kaostheory78/Projet-Balise/Schémas Electriques/Schémas V3 - Routage/Photos 3D/Face avant.PNG

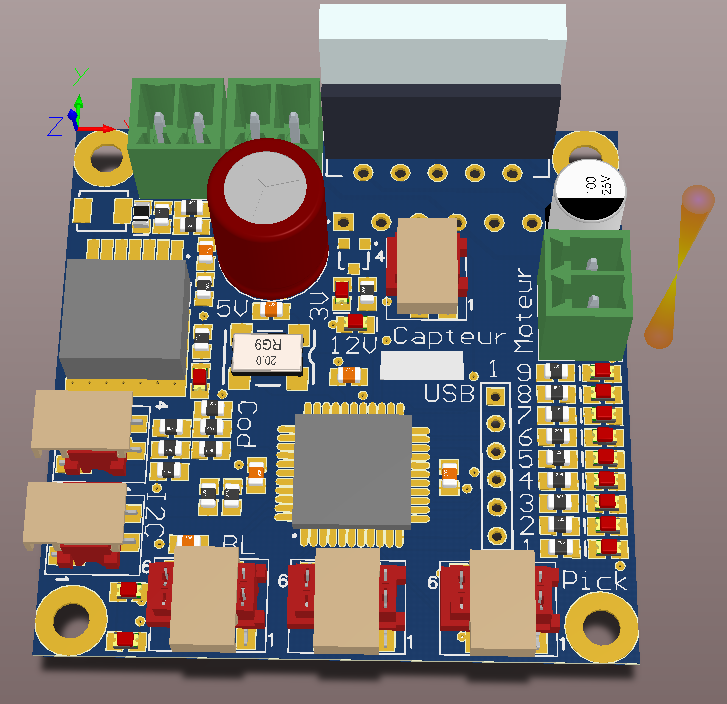
Schémas Electriques/Schémas V3 - Routage/Photos 3D/Face avant.PNG
