kaostheory78/Projet-Balise/Schémas Electriques/Schémas V3 - Routage/Photos 3D/face avant 2.PNG

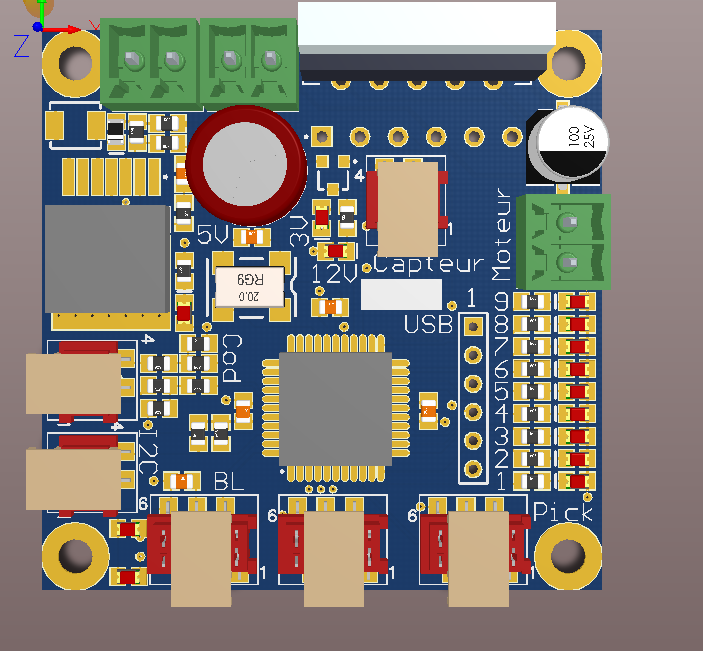
Schémas Electriques/Schémas V3 - Routage/Photos 3D/face avant 2.PNG
