kaostheory78/Projet-Balise/rapports/Cahier des charges - projet balise - V2 (1).docx

Amina chenigle

Julie labeyrie

quentin mercier

Cahier des charges projet M1B

Triangulation de la position d’un robot

Département Energie

PRJ_M1E11

2014/2015

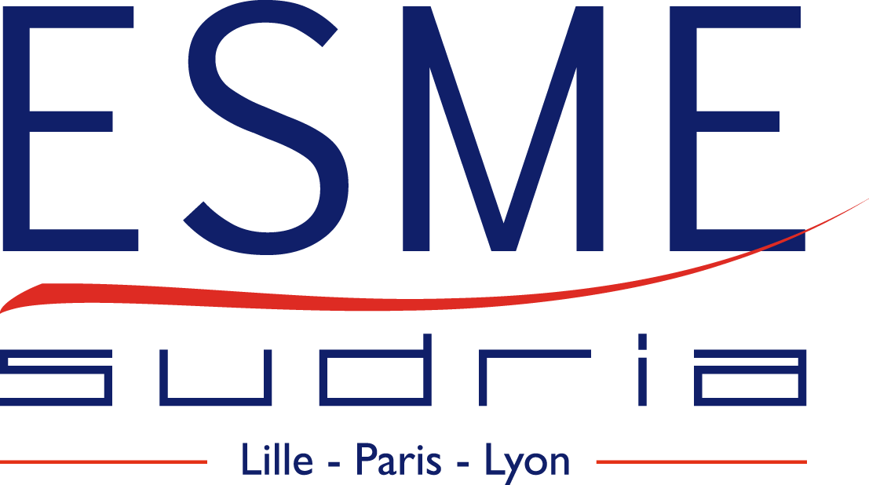
[picture p9: figure]

# Contexte :

L'objectif de notre projet est de réaliser un système de triangulation permettant de localiser un robot, dans notre cas, participant à la coupe de France de robotique (Eurobot).

Le système de triangulation sera composé de 3 balises fixes, et d’une balise sur le robot mobile dont on cherche la position. La position acquise sera transmise par liaison sans-fil par le déterminant (Bluetooth). Une interface sur un ordinateur sera également développée afin d’afficher la position ainsi calculée.

Le système devra respecter les contraintes suivantes :

# I) Contraintes mécaniques :

#### 1. Les balises fixes :

Les balises fixes seront disposées sur des mats sur les bords d’une aire de jeux où évolueront les robots dont on veut connaître la position selon la configuration suivante :

Mats de l’équipe jaune

L’aire de jeux est conçue pour accueillir deux équipes, une équipe verte et une équipe jaune, le schéma ci-dessus nous montre où sont situés les mats en fonction de la couleur de l’équipe.

Les balises fixes ont les contraintes mécaniques suivantes :

- La balise sera située à 350mm par rapport au terrain de jeu
- Hauteur maximale : 160 mm
- Base carré : 80 mm de côté
- Face inférieur recouverte de Velcro (côté velours)

#### 2. Les balises mobiles

Les balises mobiles sont celles qui seront placées sur les robots dont on veut connaître la position, celles-ci devront respecter les spécificités mécaniques suivantes :

- La balise sera placée à une hauteur de 430 mm par rapport au terrain de jeux
- Cube de 80 mm de côté
- Poids inférieur à 400g
- Face inférieur recouverte de Velcro (côté velours)
- Face supérieur recouverte de Velcro (côté crochets)

Le schéma ci-après récapitule le placement des balises.

Robot

Balise mobile

Balise fixe

# II) Contraintes électroniques

Ces balises de triangulation seront, une fois le projet fini, utilisées par l’association Sudriabotik lors de la coupe de robotique (évènement Eurobot), et seront utilisées devant un public non averti , de ce fait les contraintes suivantes devront être respectées :

- Tension maximale : 48V
- Lasers de classe 2, 3 et 4 interdits
- L’intensité lumineuse d’éléments utilisés ne doit pas être nocive pour l’œil humain
- La balise doit disposer d’une batterie pour être alimentée.
- Les balises fixes peuvent être reliées entre elles par un fil

# III) Mise en œuvre

Lors de notre réflexion pour l’élaboration de ce projet nous avons repéré différentes méthodes d’approches pour réaliser cette triangulation. Pour cela nous nous proposons de réaliser un « benchmark » des technologies et d’utiliser celle qui sera la plus adaptée. Ces technologies sont :

- Le laser
- Les émetteurs/récepteurs ultrasons
- Les émetteurs/récepteurs infrarouge
- (Caméra vidéo)

L’émetteur, sera mis en rotation autour de son axe à l’aide d’un moteur entrainant le système à vitesse constante. Dans le cas de l’utilisation d’une source lumineuse, nous utiliserons certainement un miroir.

Nous avons également identifié trois approches complètement différentes :

- La première consisterait à ce que les balises fixes soient des balises réceptrices et que les balises émettrices soient placées sur les robots. Cette technique semble à première vue être la plus simple pour obtenir la distance séparant chaque balise et ainsi pouvoir trianguler la position du robot, mais elle nécessite plus de moyens pour repérer simultanément la position de plusieurs robots.
- La seconde quant à elle serait de placer une balise réceptrice sur le robot et les émettrices sur les mats fixés autour du terrain. Le système pourrait alors repérer la position d’un grand nombre de robot simultanément, cependant la position du robot semble plus compliquée à obtenir
- Enfin la 3ème solution consiste à avoir un émetteur-récepteur sur le robot et une surface réfléchissante sur les balises fixes. C’est certainement la solution la plus simple mais, elle risque de se révéler moins précise.

Emetteur :

(Circuit de charge)

Moteur

Emetteur

Batterie

Puissance

Intelligence électronique

Interface communication filaire

Transmission sans fil

Récepteur :

(Circuit de charge)

Moteur

Conditionneur signal

Récepteur

Batterie

Puissance

Intelligence électronique

Interface communication filaire

Transmission sans fil

Notre démarche s'établira de la façon suivante :

- Mise en place d’un prototype émetteur et un prototype récepteur.
- Réaliser l’algorithme permettant d’obtenir la distance entre les deux balises.
- A partir des résultats, déterminer le choix le plus pertinent à la réalisation du projet (solution numéro 1, 2 ou 3).
- Réalisation d’un émetteur Bluetooth sur l’une des balises afin de renvoyer la position du robot, une fois celle-ci déterminée
- Optimisation du code jusqu’à l’obtention d’une position précise (5 cm) pour le robot.
- Les balises auront une autonomie d’une heure chacune
- Le temps de détermination max est de 1 seconde
- La taille du terrain sur lequel évolueront les robots est de 2m x 3m

# IV) Améliorations

Une fois le travail effectué, nous nous proposons d’améliorer le système de la façon suivante :

- Développement d’une interface recueillant les données envoyées par Bluetooth et affichant la position en temps réel sur une « carte » du terrain à l’ordinateur.
- « Optimisation » du code en étudiant les cas compliqués qui risqueraient d’entrainer des problèmes de mesures (ex : perturbations entrainées par une balise adversaire fonctionnant sur la même technologie que nous).
- Développement, à partir du prototype, et des schémas électriques, du routage de PCB sous Altium Designer en taille CMS.

Nous nous attacherons également à réaliser une base mécanique en PVC propre et répondant au cahier des charges énoncé précédemment.

Annexe :

Le schéma ci-après nous renseigne sur la disposition exacte des mâts (les distances sont en mm).

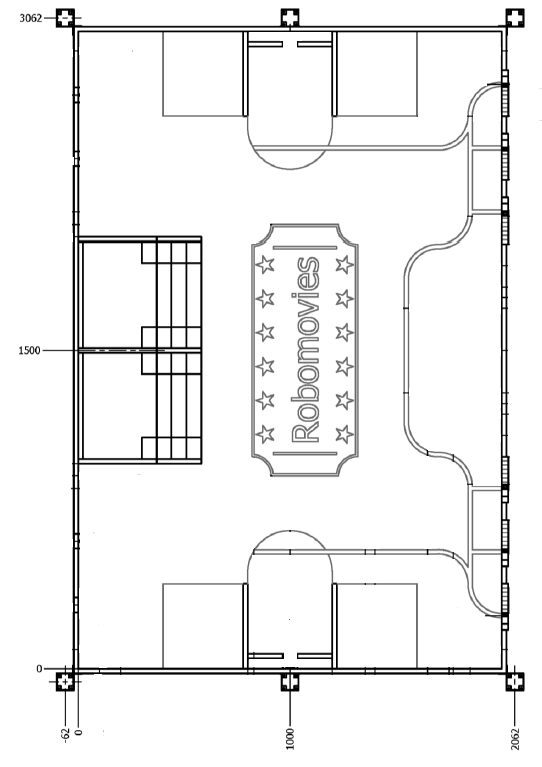
[picture p10: figure]

Position des balises fixes sur le terrain

Chenigle, Labeyrie, Mercier Page 1 / 5 PRJ_M1E11
