kaostheory78/Projet-Balise/rapports/Comparatif méthodes.xlsx

Sheet: Feuil1
 | Thème | Distance | Angle | Précision | Robustesse | Nb de coms | nombre de carte | Compléxité | Triangulation | Possibilité d'utiliser des capteurs industriels | Coût | Utilisation pour la Stratégie
IR | Balise IR simple type Freebot (environs 16 leds) 1 équipe | 2/10 | 5/10 | 0/10 | 6/10 | 1 | 4 | 1/10 | NON | NON | 2/10 | 0/10
 |  | Pas étudié pour, permet uniquement de calculer un angle et à la rigueur d'évaluer une distance | Composé de 16 leds, on a donc une précision de 22° | jusqu'à plus d'1m d'imprécision | Risque de pertubations par d'autres IR | Une balise sur notre robot une sur les robots adverses | Une sur chaque robot | Peu de mise en œuvre |  |  | Composants peu chères | Innutilisable pour tracer la position du robot
 | Balise IR XXL type RCVA (environs 32 leds) +5 équipes | 5/10 | 6/10 | 2/10 | 6/10 | 1 | 4 | 2/10 | NON | NON | 4/10 | 1/10
 |  | Pas étudié pour, permet uniquement de calculer un angle et à la rigueur d'évaluer une distance | Composé de 16 leds, on a donc une précision de 11° | Jusqu'à plus de 70 cm d'imprécision dans le pire des cas | Risque de pertubations par d'autres IR | Une balise sur notre robot une sur les robots adverses | Une sur chaque robot | Peu de mise en œuvre mais une bonne partie hardwaez |  |  | Composants peu chères | Innutilisable pour tracer la position du robot
 | Balise IR - Emeteur/Recepteur séparés Aucune équipe connue à ce jour | 5/10 | 7/10 |  | 4/10 | 7 | 7 | 10/10 | OUI | A voir | 7/10 | 5/10
 |  | Estimation du temps de vol en connaissant la vitesse de rotation de l'éméteur, et en mesurant le temps entre deux états-hauts sur les récepteurs | En cas de synchro rapide avec l'éméteur, peut permetre de récupérer un angle assez précis | Assez lent pour avoir des mesures exploitables | Système relativement pertubable et obligeant à fonctionner à vitesse lente ==> Temps de réponse assez lent | 7 Minimum : 3 balises fixes vers 2 éméteurs plus mobiles plus transfert vers le deuxième robot | Une carte par balise et par robot | Beuacoup de hardware, beaucoup de software, nécéssite une bonne snchronisation. Méthode peu ou pas connue, beaucoup de travail de recherche |  |  | Beaucoup de cartes et beaucoup de composants | Peu de précision car système par définition assez lent
 | Balise IR / Réflecteurs (même technique sans triangulation chez Eceborg, CVRA, Microb, …) | 6/10 | 8/10 | 8/10 | 8/10 | 3 | 4 | 6/10 | OUI | OUI | 5/10 | 8/10
 |  | évaluation possible de la distance par mesure du temps à l'état haut | Obtention de l'angle par rotation d'un moteur et des codeurs (moyennage à 0,5°) | Précis à environ 0,5° soit une erreur de moins de 5 cm | Peu ou pas pertubable | Une par éméteur à la cate de calcul et une au second robot (peut être réduit à 2) | Une par robot | Légère compléxité mécanique |  |  |  | Relevé de position précis
Ultrasons | Balises ultrasons 2 équipes : uart et l'ESEO | 8/10 | 0/10 | 8/10 | 4/10 | 7 | 7 | 9/10 ?? | OUI | NON | 6/10 | 8/10
 |  | Relativemment précis mais dépend des conditions ambiantes | Mesure de temps de vol, mesure de l'angle impossible | Environ 4 cm pour les systèmes existants (Eseo 2011) | Très pertubable, fréquence de drivers de moteurs, zoom de caméras, bruit du publique … | Une par balise et par robot | Une par balise et par robot | Très peu d'informations sur des balises "fonctionnelles sur cette techno |  |  | Beaucoup de cartes | Position plutôt précise pour être utile
Laser | Balise laser type Microb Technology | 10/10 | 10/10 | 10/10 | 10/10 | 7 | 7 | 10/10 | OUI | OUI | 10/10 | 10/10
 |  | Mesure de temps de vol télémétrique (ordre du mm) | précis à 0,1° minimum | Position du robot au cm près minimum (par l'angle) | Seulement une équipe avec le même type de technologie donc non pertubable |  |  | Beaucoup de travail de mise en œuvre |  |  | Laser de classe 1 hors de prix | Solution la plus précise possible
 | Balise laser Balayage laser Type EPFL (suisses) | 8/10 | 8/10 | 8/10 | 6/10 | 7 | 7 | 8/10 | OUI | OUI | 10/10 | 7/10
 |  |  |  |  | Système assez lent
 | Balise laser tournant vs IR (Pas d'équipe) | 4/10 | 6/10 |  | 8/10 | 1 | 4 | 2/10 | NON | OUI | 4/10 | 2/10
 |  | Pas de mesure de temsp de vol | Permet de récupérer un angle dans la mesure de précision des récepteurs IR | Précision limitée car pas de triangulation | Peu pertubable | Recepeteur sur notre robot donc 1 com pour transférer au deuxième robot | Une carte par robot | plutôt simple |  |  | prix du laser IR | Pas de triangulation donc peu utile
 | Légendes | Système Intéressant | Hors Budget | Hors sujet
 |  | Critère satisfaisant | Critère acceptable | critère insatisfaisant

Sheet: Feuil2
Méthode | imprécision |  | données |  |  |  | a1 | a2
IR simple | 22 |  | B1x | 1000 | B1Y | 0 | 90 | 45
 |  |  | B2X | 2000 | B2Y | 3000 | 68 | 23
 |  |  | B3x | 0 | B3Y | 3000 | 112 | 67
 |  |  |  |  |  |  | 68 | 67
 |  |  |  |  |  |  | 112 | 23
 | Formules | Rx | Ry |  | Erreur distance
 | pas d'erreur | 2000 | 1000 |  | 0
 | -22 -22 | 3108.656541 | 2255.97877 |  | 1675.291615
 | +22 +22 | 330.0230594 | 866.6620289 |  | 1675.291615
 | -22 +22 | 13371.31038 | 6402.360065 |  | 12589.36829
 | +22 -22 | 2198.486961 | 111.7536106 |  | 910.153131
IR XXL | imrécision |  | données |  |  |  | a1 | a2
 | 11 |  | B1x | 1000 | B1Y | 0 | 90 | 45
 |  |  | B2X | 2000 | B2Y | 3000 | 79 | 34
 |  |  | B3x | 0 | B3Y | 3000 | 101 | 56
 |  |  |  |  |  |  | 79 | 56
 |  |  |  |  |  |  | 101 | 34
 | Formules | Rx | Ry |  | Erreur distance
 | pas d'erreur | 2000 | 1000 |  | 0
 | -11 -11 | 2676.397041 | 1520.238884 |  | 853.3237688
 | +11 +11 | 1177.970668 | 771.0256975 |  | 853.3237688
 | -11 +11 | 2131.775501 | 1414.375181 |  | 434.8236116
 | +11 -11 | 2055.935382 | 600.366645 |  | 403.5289152
Balise IR réflecteurs | imprécisions |  | données |  |  |  | a1 | a2
 | 0.5 |  | B1x | 1000 | B1Y | 0 | 90 | 45
 |  |  | B2X | 2000 | B2Y | 3000 | 89.5 | 44.5
 |  |  | B3x | 0 | B3Y | 3000 | 90.5 | 45.5
 |  |  |  |  |  |  | 89.5 | 45.5
 |  |  |  |  |  |  | 90.5 | 44.5
 | Formules | Rx | Ry |  | Erreur distance
 | pas d'erreur | 2000 | 1000 |  | 0
 | -0,5 -0,5 | 2034.752508 | 1017.757016 |  | 39.02625316
 | +0,5 +0,5 | 1964.942882 | 982.8522032 |  | 39.02625316
 | -0,5 +0,5 | 2000.155034 | 1017.455089 |  | 17.45577703
 | +0,5 -0,5 | 2000.149715 | 982.5449579 |  | 17.45568417
laser par l'angle | imprécisions |  | données |  |  |  | a1 | a2
 | 0.1 |  | B1x | 1000 | B1Y | 0 | 90 | 45
 |  |  | B2X | 2000 | B2Y | 3000 | 89.9 | 44.9
 |  |  | B3x | 0 | B3Y | 3000 | 90.1 | 45.1
 |  |  |  |  |  |  | 89.9 | 45.1
 |  |  |  |  |  |  | 90.1 | 44.9
 | Formules | Rx | Ry |  | Erreur distance
 | pas d'erreur | 2000 | 1000 |  | 0
 | -0,1 -0,1 | 2006.97521 | 1003.502836 |  | 7.805345738
 | +0,1 +0,1 | 1993.012605 | 996.5215333 |  | 7.805345738
 | -0,1 +0,1 | 2000.006114 | 1003.490673 |  | 3.490678073
 | +0,1 -0,1 | 2000.006071 | 996.5093274 |  | 3.490677924
