kaostheory78/Projet-Balise/rapports/Gantt projet.xlsx

Taches | date début | nombres de semaines | date fin
Tableau comparatif | 2015-01-26 | 1 | 7
Choix de la technologie | 2015-02-02 | 1 | 7
Mode utilisation | 2015-02-02 | 1 | 7
Rapport expliquant choix | 2015-02-02 | 1 | 7
Proto elec | 2015-02-09 | 2 | 14
Proto Meca | 2015-02-09 | 2 | 14
Rapport Protos | 2015-02-16 | 1 | 7
Schémas elec finaux | 2015-02-23 | 1 | 7
Code bas niveau | 2015-02-23 | 1 | 7
Algo haut niveau | 2015-03-02 | 2 | 14
Raport codes | 2015-03-09 | 1 | 7
Test et optimisation | 2015-03-16 | 4 | 28
Logiciel haut niveau | 2015-03-23 | 3 | 21
Routage carte | 2015-03-23 | 2 | 14
Rapport | 2015-04-06 | 1 | 7
Carte finale + méca finale | 2015-04-13 | 2 | 14
Rapport finale | 2015-04-20 | 3 | 21
soutenance | 2015-05-10 | 1 | 7
