kaostheory78/Projet-Balise/rapports/Schémas explicatifs/schéma 1.PNG

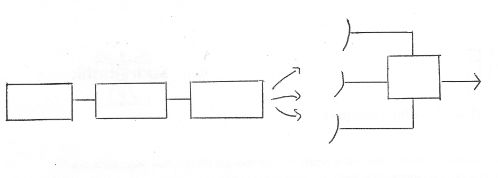
rapports/Schémas explicatifs/schéma 1.PNG
