kaostheory78/Projet-Balise/rapports/Schémas explicatifs/schéma 2.PNG

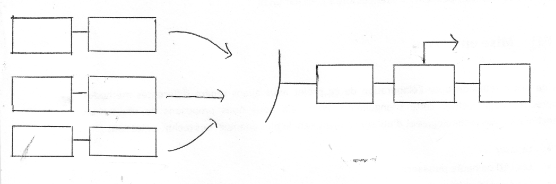
rapports/Schémas explicatifs/schéma 2.PNG
