kaostheory78/Projet-Balise/rapports/Schémas explicatifs/schéma 3.PNG

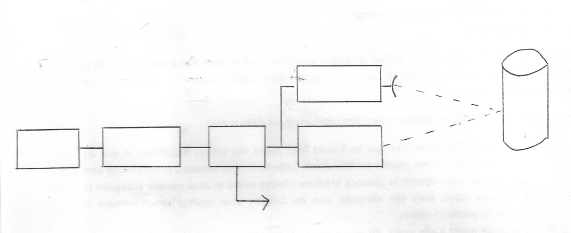
rapports/Schémas explicatifs/schéma 3.PNG
