kaostheory78/Projet-Balise/Schémas Electriques/Schémas V2 - wrapping/Schémas V2 - BOM.xlsx

Report Generated From Altium Designer
Designator | Description | Value | Quantity | Référence
C1, C4 | Capacitor | 27pF | 2
C2, C3 | Capacitor | 10nF | 2
C5 | Capacitor | 220uF | 1
C6, C10, C14 | Capacitor | 1uF | 3
C7 | Capacitor | 100pF | 1
C8 | Capacitor | 100uF | 1
C11, C15 | Capacitor | 10uF | 2
C12 | Capacitor | 330uF | 1
C9, C13, Cap1, Cap2, Cap3, Cap4 | Capacitor | 0.1uF | 6
C16 | Capacitor | 0.2uF | 1
D1, D2, D4, D5, D6 | LED ROUGE |  | 5
D3 | Schottky Diode 1N5820 |  | 1 | 774-3341
J1, J2 | Connecteur 2 voies |  | 2
L1 | Inductor | 15uH | 1 | RS : 540-8538
P1, P4 | Header, 6-Pin |  | 2
P2, P3, P6 | Header, 4-Pin |  | 3
P5 | Header, 2-Pin |  | 1
Q1 | P-Channel Power MOSFET |  | 1 | Farn : 952-4851
Q2 | NPN Bipolar Transistor BC237 |  | 1 | RS : 625-4691
R1, R3, R5, R11, R18, R22 | Resistor | 10K | 6
R2 | Resistor | 100 | 1
R4, R8 | Resistor | 15k | 2
R6, R7, R16, R19, R21 | Resistor | 1K | 5
R9 | Resistor | 330 | 1
R10, R14 | Resistor | 330 | 2
R12 | Resistor | 0R | 1
R13 | Resistor | 3K4 | 1
R15 | Resistor | 470 | 1
R17 | Resistor | 17.4k | 1
R20 | Resistor | 2k | 1
S1 | bouton |  | 1
U1 | PIC 18F4431-I/PT |  | 1
U2 | LMD18200T |  | 1
VR1 | LM2588 |  | 1 | Farn : 9493719
VR2 | LM1117T-5.0 |  | 1 | RS : 535-9256
VR3 | LM1117T-3.0 |  | 1 | RS : 535-9262
Y1 | Crystal Oscillator |  | 1
vendredi 27-févr.-27/2015 3:45:48 PM |  |  |  |  | Page 1 of 1
