kaostheory78/Projet-Balise/Schémas Electriques/Schémas V3 - Routage/Fabrication Outputs/BOM/Bill of Materials-Carte Balise.xls

Description | Designator | Footprint | Quantity | value | Supplier 1 | Supplier Part Number 1 | Supplier 2 | Supplier Part Number 2
Resistor 0805 | R15, R24, R26, R28, R30, R37, R38, R39, R40, R41, R42 | 0805 | 11 | 0R
Resistor 0805 | R2 | 0805 | 1 | 100R
Resistor 0805 | R1, R10, R23, R29, R31 | 0805 | 5 | 10K
Resistor 0805 | R11 | 0805 | 1 | 15k
Resistor 0805 | R19 | 0805 | 1 | 17K4
Resistor 0805 | R3, R4, R12, R13, R14, R18, R20, R25, R27 | 0805 | 9 | 1K
Resistor 0805 | R22 | 0805 | 1 | 215K
Resistor 0805 | R21 | 0805 | 1 | 2k
Resistor 0805 | R5, R6, R16, R43, R44 | 0805 | 5 | 330R
Resistor 0805 | R32 | 0805 | 1 | 3k4
Resistor 0805 | R7, R8, R9, R17, R35, R36, R45, R46, R47 | 0805 | 9 | 470R
connecteur WE, Header, 4-Pin, Header, 4-Pin | J4, P2, P5 | 690367280476 | 3 | 690367280476 | Farnell | 378-4710
Header, 6-Pin | J5, P1, P3 | 690367280676 | 3 | 690367280676 | Farnell | 129-1787
WR-TBL Terminal block - serie 3211 - 3.50 mm | J1, J2, J3 | 691321100002 | 3 | 691321100002 | Farnell | 3704816
Capacitor 0805 | C1, C2, C3, C4, C5, C6, C8, C14, C18 | C0805 | 9 | 100nF
Capacitor 0805 | C7, C22 | C0805 | 2 | 100pF
Capacitor 0805 | C9, C10 | C0805 | 2 | 10nF
Capacitor 0805 | C16, C20 | C0805 | 2 | 10uF
Capacitor 0805 | C12, C15, C19 | C0805 | 3 | 1uF
Capacitor 0805 | C21 | C0805 | 1 | 200nF
Capacitor 1206 | C13 | C1206 | 1 | 100uF | Farnell | 221-1193
EEEFK1C221XP | C11 | Capa CMS D6.3_E1.8 | 1 | 220uF | Farnell | 185-0103
EEUFM1C122L | C17 | CAPA_D10_E5 | 1 | 1200uF | Farnell | 185-5216
Schottky Diode 0805 | D5 | D0805 | 1 | SD0805S040S0R5 | Farnell | 240-0203
Header, 6-Pin | P4 | HDR1X6 | 1 | 690367280676 | Farnell | 129-1787
SRP4020TA-150M | L1 | Inductance 4.06 x 4.45 | 1 | 15uH | farnell | 243-4809
Oscillateur quartz | K1 | IQXO-70 | 1 | 10Mhz | Farnell | 478-8625
Typical RED, GREEN, YELLOW, AMBER GaAs LED 0805 | D1, D2, D8, D13, D14 | LED 0805 | 5 | Bleu
Typical RED, GREEN, YELLOW, AMBER GaAs LED 0805 | D6 | LED 0805 | 1 | Orange
Typical RED, GREEN, YELLOW, AMBER GaAs LED 0805 | D4, D7, D12, D16, D17 | LED 0805 | 5 | Rouge
Typical RED, GREEN, YELLOW, AMBER GaAs LED 0805 | D3, D11, D15 | LED 0805 | 3 | Vert
800mA Low-Dropout Linear Regulator | U5 | MP04A_N | 1 | LM1117IMP-5.0 | Farnell | 240-0655
800mA Low-Dropout Linear Regulator | U3 | MP04A_N | 1 | LM1117MP-3.3 | Farnell | 977-8195
P-Channel Power MOSFET | Q1 | SOT-23 | 1 | NDS0605 | Farnell | 984-6352
NPN Bipolar Transistor | Q2 | SOT23_L | 1 | MMBT2222ALT1G | RS | 544-9400
3A, 55V H-Bridge | U2 | TA11B | 1 | LMD18200T | Farnell | 948-8030
High-Performance 16-bit Digital Signal Controller, 128 KB Flash, 16 KB RAM, 44-Pin TQFP, Industrial Temperature, Tape and Reel | U1 | TQFP-PT44_N | 1 |  | farnell | 157-6810 | Newark | 39M8148
SIMPLE SWITCHER 5A Flyback Regulator with Shutdown | U4 | TS7B_N | 1 | LM2588S-ADJ | Farnell | 232-3492 |  | 533-3412
