kaostheory78/Projet-Balise/Méca/capteur sick.SLDASM

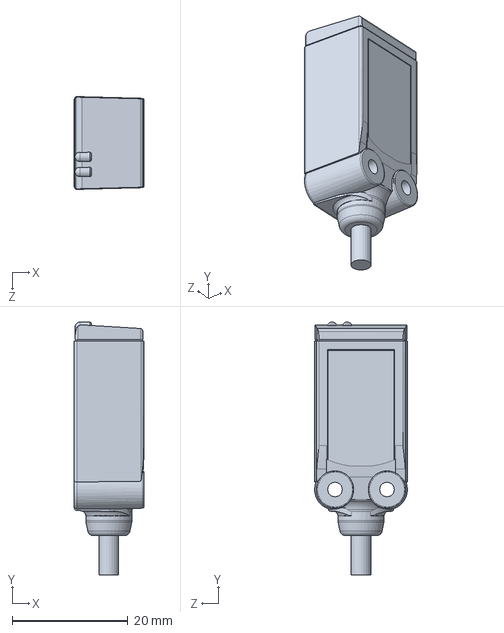
[picture p29: CAD file, 2017-03-19]
Méca/capteur sick.SLDASM
12.1 x 43.8 x 16.1 mm
