kaostheory78/Projet-Balise/Méca/toit.SLDASM

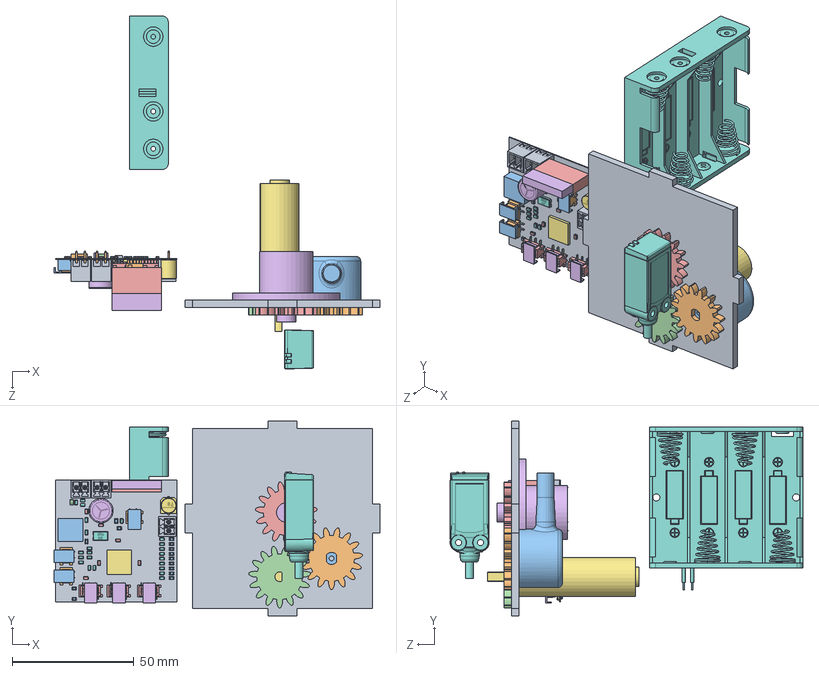
[picture p30: CAD file, 2017-03-19]
Méca/toit.SLDASM
133.7 x 80.0 x 144.9 mm
socle
roue 1 - codeur
codeur
roue 1 - moteur
roue 1 - collecteur
collecteur tournant
moteur
_SICK WL4-3F3130-Order no.1028153_1
Board
Extruded
Extruded_2
Extruded_3
Extruded_4
Extruded_5
Extruded_6
SW3dPS-0805_SMD_Resistor x 45
Extruded_7
Geh__X2__00E4__X0__use x 3
Pick_Pad x 3
Pin x 12
Geh__X2__00E4__X0__use_2 x 3
Pick_Pad_2 x 3
Pin_2 x 18
User_Library-GeyerElectronics_KX12B
6913211000xx_PIN x 6
User_Library-led_0805LED0805_red x 14
User_Library-D0805
SW3dPS-0805_SMD_Capacitor x 19
SW3DPS-ELECTROLITIC_CAPACITOR_RADIAL_10X12-DEFAULT
User_Library-6_3x7_7
User Library-Battery Holder 4xAA
