kaostheory78/Projet-Balise/Schémas Electriques/Schémas V3 - Routage/Fabrication Outputs/ExportSTEP/PCB3 - 5x5 - placement V2.SLDASM

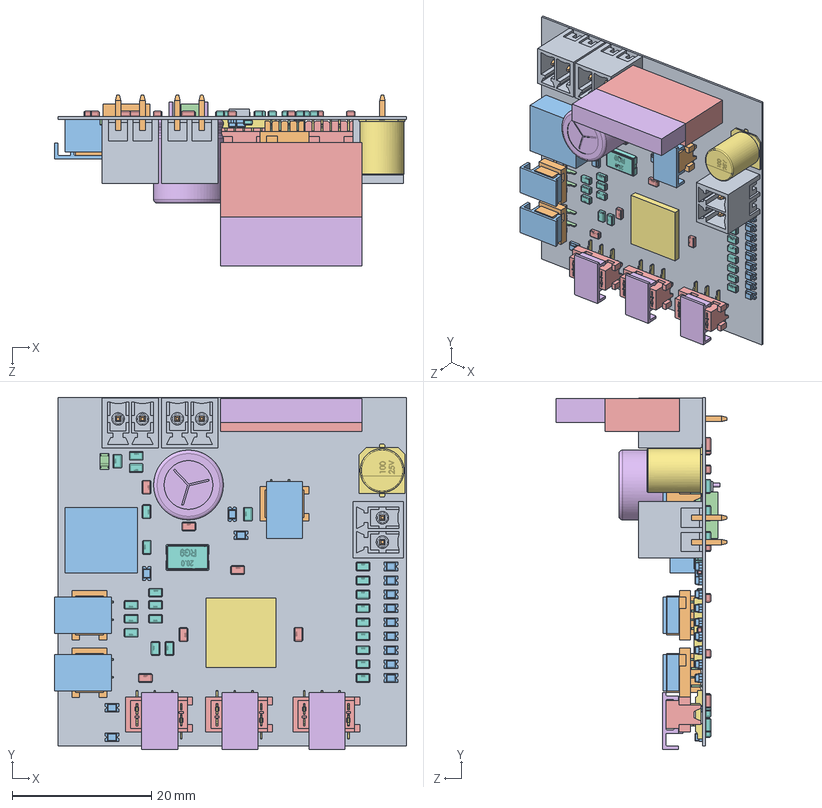
[picture p32: CAD file, 2017-03-19]
Schémas Electriques/Schémas V3 - Routage/Fabrication Outputs/ExportSTEP/PCB3 - 5x5 - placement V2.SLDASM
50.5 x 50.5 x 24.5 mm
Board
Extruded
Extruded_2
Extruded_3
Extruded_4
Extruded_5
Extruded_6
SW3dPS-0805_SMD_Resistor x 45
Extruded_7
Geh__X2__00E4__X0__use x 3
Pick_Pad x 3
Pin x 12
Geh__X2__00E4__X0__use_2 x 3
Pick_Pad_2 x 3
Pin_2 x 18
User_Library-GeyerElectronics_KX12B
6913211000xx_PIN x 6
User_Library-led_0805LED0805_red x 14
User_Library-D0805
SW3dPS-0805_SMD_Capacitor x 19
SW3DPS-ELECTROLITIC_CAPACITOR_RADIAL_10X12-DEFAULT
User_Library-6_3x7_7
