kaostheory78/Projet-Balise/Méca/roue 1 - codeur.SLDPRT

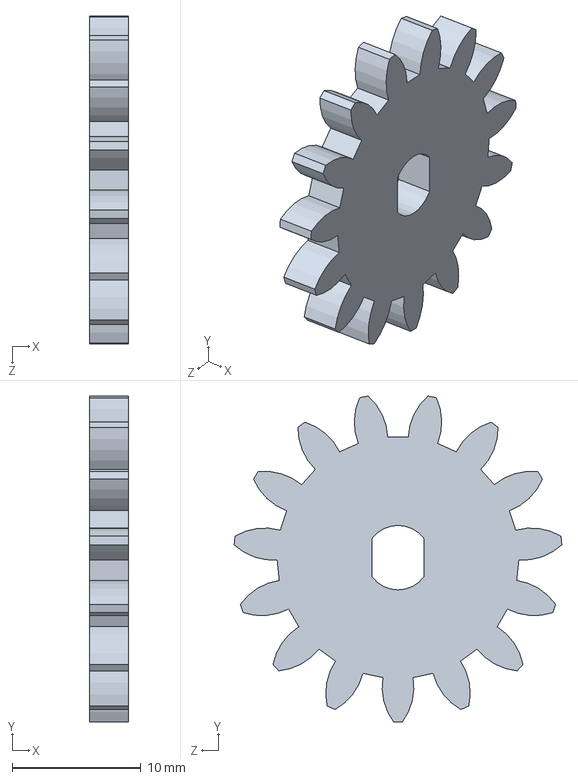
[picture p33: CAD file, 2017-03-19]
Méca/roue 1 - codeur.SLDPRT
3.00 x 25.3 x 25.4 mm
