kaostheory78/Projet-Balise/Méca/codeur.SLDPRT

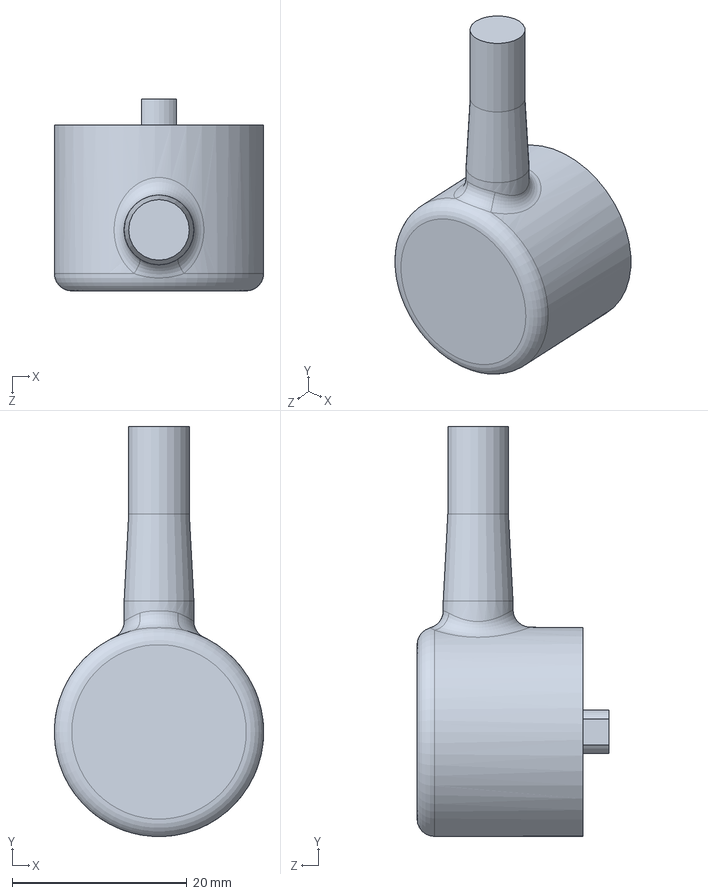
[picture p34: CAD file, 2017-03-19]
Méca/codeur.SLDPRT
24.0 x 47.0 x 22.0 mm
