kaostheory78/Projet-Balise/Méca/moteur.SLDPRT

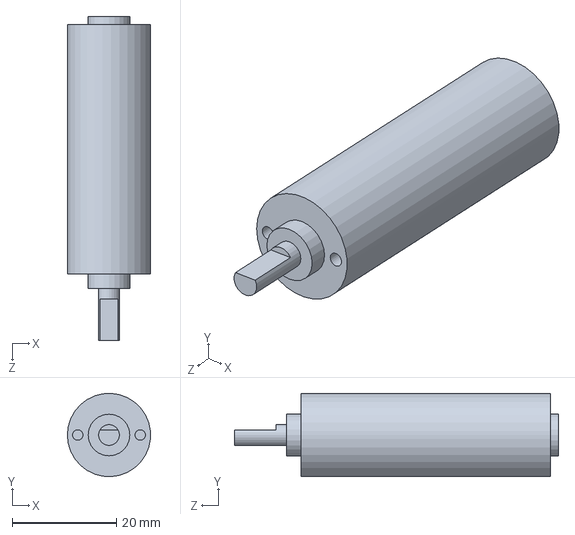
[picture p35: CAD file, 2017-03-19]
Méca/moteur.SLDPRT
16.0 x 16.0 x 62.2 mm
