kaostheory78/Projet-Balise/Méca/socle.SLDPRT

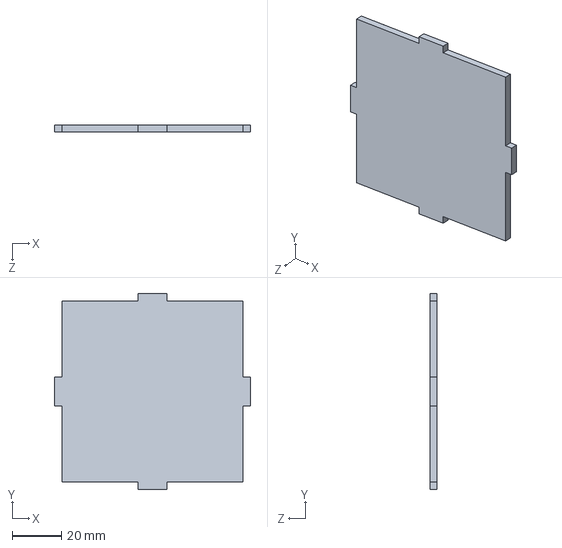
[picture p36: CAD file, 2017-03-19]
Méca/socle.SLDPRT
80.0 x 80.0 x 3.00 mm
