kaostheory78/Projet-Balise/Méca/collecteur tournant.SLDPRT

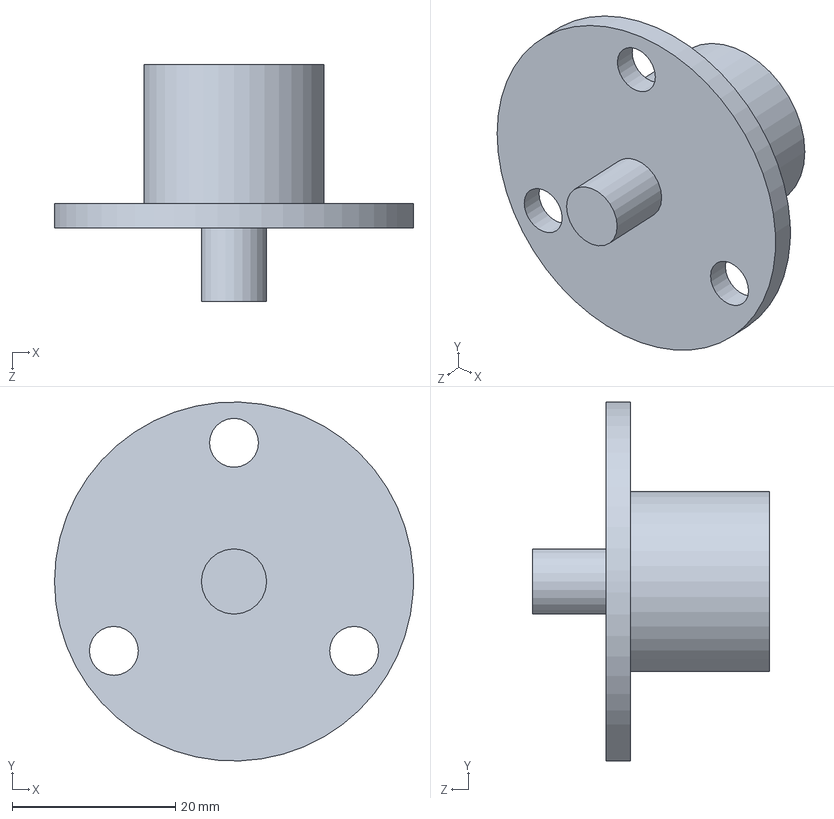
[picture p37: CAD file, 2017-03-19]
Méca/collecteur tournant.SLDPRT
44.0 x 44.0 x 29.0 mm
