kaostheory78/Projet-Balise/Méca/Pile 9V.SLDPRT

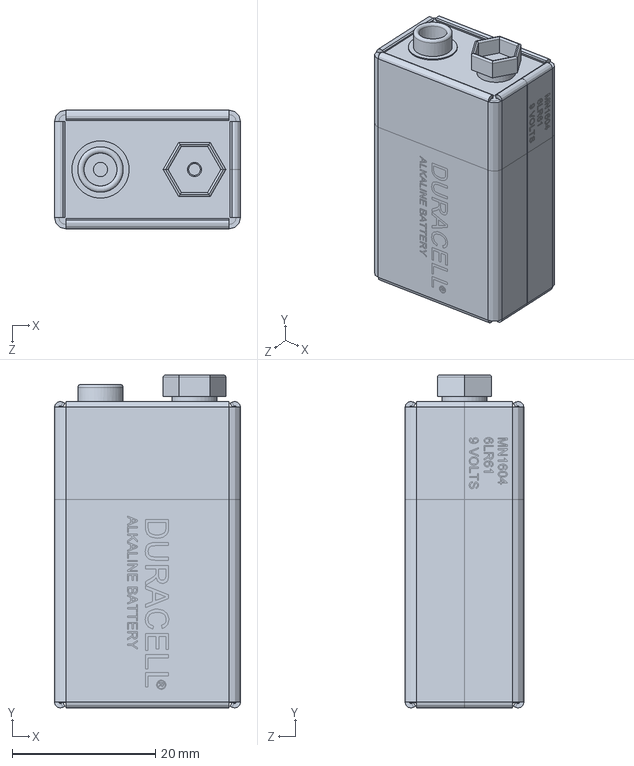
[picture p38: CAD file, 2017-03-19]
Méca/Pile 9V.SLDPRT
26.0 x 46.5 x 16.6 mm
