kaostheory78/Projet-Balise/Méca/User Library-Battery Holder 4xAA.SLDPRT

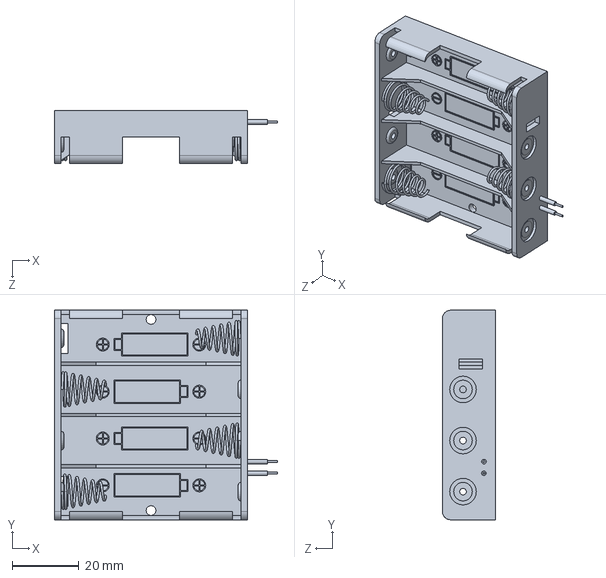
[picture p39: CAD file, 2017-03-19]
Méca/User Library-Battery Holder 4xAA.SLDPRT
67.0 x 63.0 x 16.0 mm
