kaostheory78/Projet-Balise/(list of files, cad)

Other CAD files:
Schémas Electriques/Schémas V3 - Routage/Fabrication Outputs/ExportSTEP/D5.sldasm
Schémas Electriques/Schémas V3 - Routage/Fabrication Outputs/ExportSTEP/U2.sldasm
Schémas Electriques/Schémas V3 - Routage/Fabrication Outputs/ExportSTEP/C20.sldasm
Schémas Electriques/Schémas V3 - Routage/Fabrication Outputs/ExportSTEP/C5.sldasm
Schémas Electriques/Schémas V3 - Routage/Fabrication Outputs/ExportSTEP/C8.sldasm
Schémas Electriques/Schémas V3 - Routage/Fabrication Outputs/ExportSTEP/R11.sldasm
Schémas Electriques/Schémas V3 - Routage/Fabrication Outputs/ExportSTEP/C1.sldasm
Schémas Electriques/Schémas V3 - Routage/Fabrication Outputs/ExportSTEP/D4.sldasm
Schémas Electriques/Schémas V3 - Routage/Fabrication Outputs/ExportSTEP/D9.sldasm
Schémas Electriques/Schémas V3 - Routage/Fabrication Outputs/ExportSTEP/D6.sldasm
Schémas Electriques/Schémas V3 - Routage/Fabrication Outputs/ExportSTEP/R38.sldasm
Schémas Electriques/Schémas V3 - Routage/Fabrication Outputs/ExportSTEP/R35.sldasm
Schémas Electriques/Schémas V3 - Routage/Fabrication Outputs/ExportSTEP/K1.sldasm
Schémas Electriques/Schémas V3 - Routage/Fabrication Outputs/ExportSTEP/R23.sldasm
Schémas Electriques/Schémas V3 - Routage/Fabrication Outputs/ExportSTEP/R6.sldasm
Schémas Electriques/Schémas V3 - Routage/Fabrication Outputs/ExportSTEP/U3.sldasm
Schémas Electriques/Schémas V3 - Routage/Fabrication Outputs/ExportSTEP/P1.sldasm
Schémas Electriques/Schémas V3 - Routage/Fabrication Outputs/ExportSTEP/D15.sldasm
Schémas Electriques/Schémas V3 - Routage/Fabrication Outputs/ExportSTEP/R41.sldasm
Schémas Electriques/Schémas V3 - Routage/Fabrication Outputs/ExportSTEP/J2.sldasm
Schémas Electriques/Schémas V3 - Routage/Fabrication Outputs/ExportSTEP/C16.sldasm
Schémas Electriques/Schémas V3 - Routage/Fabrication Outputs/ExportSTEP/J3.sldasm
Schémas Electriques/Schémas V3 - Routage/Fabrication Outputs/ExportSTEP/R24.sldasm
Schémas Electriques/Schémas V3 - Routage/Fabrication Outputs/ExportSTEP/R5.sldasm
Schémas Electriques/Schémas V3 - Routage/Fabrication Outputs/ExportSTEP/R37.sldasm
Schémas Electriques/Schémas V3 - Routage/Fabrication Outputs/ExportSTEP/P3.sldasm
Schémas Electriques/Schémas V3 - Routage/Fabrication Outputs/ExportSTEP/R42.sldasm
Schémas Electriques/Schémas V3 - Routage/Fabrication Outputs/ExportSTEP/R17.sldasm
Schémas Electriques/Schémas V3 - Routage/Fabrication Outputs/ExportSTEP/R27.sldasm
Schémas Electriques/Schémas V3 - Routage/Fabrication Outputs/ExportSTEP/R13.sldasm
Schémas Electriques/Schémas V3 - Routage/Fabrication Outputs/ExportSTEP/R19.sldasm
Schémas Electriques/Schémas V3 - Routage/Fabrication Outputs/ExportSTEP/R34.sldasm
Schémas Electriques/Schémas V3 - Routage/Fabrication Outputs/ExportSTEP/C22.sldasm
Schémas Electriques/Schémas V3 - Routage/Fabrication Outputs/ExportSTEP/P2.sldasm
Schémas Electriques/Schémas V3 - Routage/Fabrication Outputs/ExportSTEP/C21.sldasm
Schémas Electriques/Schémas V3 - Routage/Fabrication Outputs/ExportSTEP/C13.sldasm
Schémas Electriques/Schémas V3 - Routage/Fabrication Outputs/ExportSTEP/J1.sldasm
Schémas Electriques/Schémas V3 - Routage/Fabrication Outputs/ExportSTEP/C12.sldasm
Schémas Electriques/Schémas V3 - Routage/Fabrication Outputs/ExportSTEP/C9.sldasm
Schémas Electriques/Schémas V3 - Routage/Fabrication Outputs/ExportSTEP/D13.sldasm
Schémas Electriques/Schémas V3 - Routage/Fabrication Outputs/ExportSTEP/D2.sldasm
Schémas Electriques/Schémas V3 - Routage/Fabrication Outputs/ExportSTEP/U4.sldasm
Schémas Electriques/Schémas V3 - Routage/Fabrication Outputs/ExportSTEP/C15.sldasm
Schémas Electriques/Schémas V3 - Routage/Fabrication Outputs/ExportSTEP/P4.sldasm
Schémas Electriques/Schémas V3 - Routage/Fabrication Outputs/ExportSTEP/U1.sldasm
Schémas Electriques/Schémas V3 - Routage/Fabrication Outputs/ExportSTEP/R44.sldasm
Schémas Electriques/Schémas V3 - Routage/Fabrication Outputs/ExportSTEP/C4.sldasm
Schémas Electriques/Schémas V3 - Routage/Fabrication Outputs/ExportSTEP/D11.sldasm
Schémas Electriques/Schémas V3 - Routage/Fabrication Outputs/ExportSTEP/R39.sldasm
Schémas Electriques/Schémas V3 - Routage/Fabrication Outputs/ExportSTEP/C10.sldasm
Schémas Electriques/Schémas V3 - Routage/Fabrication Outputs/ExportSTEP/C2.sldasm
Schémas Electriques/Schémas V3 - Routage/Fabrication Outputs/ExportSTEP/D10.sldasm
Schémas Electriques/Schémas V3 - Routage/Fabrication Outputs/ExportSTEP/R32.sldasm
Schémas Electriques/Schémas V3 - Routage/Fabrication Outputs/ExportSTEP/U5.sldasm
Schémas Electriques/Schémas V3 - Routage/Fabrication Outputs/ExportSTEP/R28.sldasm
Schémas Electriques/Schémas V3 - Routage/Fabrication Outputs/ExportSTEP/C17.sldasm
Schémas Electriques/Schémas V3 - Routage/Fabrication Outputs/ExportSTEP/R1.sldasm
Schémas Electriques/Schémas V3 - Routage/Fabrication Outputs/ExportSTEP/R30.sldasm
Schémas Electriques/Schémas V3 - Routage/Fabrication Outputs/ExportSTEP/R25.sldasm
Schémas Electriques/Schémas V3 - Routage/Fabrication Outputs/ExportSTEP/D12.sldasm
Schémas Electriques/Schémas V3 - Routage/Fabrication Outputs/ExportSTEP/C3.sldasm
Schémas Electriques/Schémas V3 - Routage/Fabrication Outputs/ExportSTEP/D3.sldasm
Schémas Electriques/Schémas V3 - Routage/Fabrication Outputs/ExportSTEP/R26.sldasm
Schémas Electriques/Schémas V3 - Routage/Fabrication Outputs/ExportSTEP/R7.sldasm
Schémas Electriques/Schémas V3 - Routage/Fabrication Outputs/ExportSTEP/R9.sldasm
Schémas Electriques/Schémas V3 - Routage/Fabrication Outputs/ExportSTEP/D8.sldasm
Schémas Electriques/Schémas V3 - Routage/Fabrication Outputs/ExportSTEP/C7.sldasm
Schémas Electriques/Schémas V3 - Routage/Fabrication Outputs/ExportSTEP/R12.sldasm
Schémas Electriques/Schémas V3 - Routage/Fabrication Outputs/ExportSTEP/R10.sldasm
Schémas Electriques/Schémas V3 - Routage/Fabrication Outputs/ExportSTEP/R45.sldasm
Schémas Electriques/Schémas V3 - Routage/Fabrication Outputs/ExportSTEP/C11.sldasm
Schémas Electriques/Schémas V3 - Routage/Fabrication Outputs/ExportSTEP/D7.sldasm
Schémas Electriques/Schémas V3 - Routage/Fabrication Outputs/ExportSTEP/C6.sldasm
Schémas Electriques/Schémas V3 - Routage/Fabrication Outputs/ExportSTEP/C14.sldasm
Schémas Electriques/Schémas V3 - Routage/Fabrication Outputs/ExportSTEP/J5.sldasm
Schémas Electriques/Schémas V3 - Routage/Fabrication Outputs/ExportSTEP/R22.sldasm
Schémas Electriques/Schémas V3 - Routage/Fabrication Outputs/ExportSTEP/R18.sldasm
Schémas Electriques/Schémas V3 - Routage/Fabrication Outputs/ExportSTEP/R33.sldasm
Schémas Electriques/Schémas V3 - Routage/Fabrication Outputs/ExportSTEP/R4.sldasm
Schémas Electriques/Schémas V3 - Routage/Fabrication Outputs/ExportSTEP/R16.sldasm
Schémas Electriques/Schémas V3 - Routage/Fabrication Outputs/ExportSTEP/R43.sldasm
Schémas Electriques/Schémas V3 - Routage/Fabrication Outputs/ExportSTEP/R21.sldasm
Schémas Electriques/Schémas V3 - Routage/Fabrication Outputs/ExportSTEP/J4.sldasm
Schémas Electriques/Schémas V3 - Routage/Fabrication Outputs/ExportSTEP/R36.sldasm
Schémas Electriques/Schémas V3 - Routage/Fabrication Outputs/ExportSTEP/R15.sldasm
Schémas Electriques/Schémas V3 - Routage/Fabrication Outputs/ExportSTEP/R29.sldasm
Schémas Electriques/Schémas V3 - Routage/Fabrication Outputs/ExportSTEP/R14.sldasm
Schémas Electriques/Schémas V3 - Routage/Fabrication Outputs/ExportSTEP/R31.sldasm
Schémas Electriques/Schémas V3 - Routage/Fabrication Outputs/ExportSTEP/D1.sldasm
Schémas Electriques/Schémas V3 - Routage/Fabrication Outputs/ExportSTEP/R20.sldasm
Schémas Electriques/Schémas V3 - Routage/Fabrication Outputs/ExportSTEP/R8.sldasm
Schémas Electriques/Schémas V3 - Routage/Fabrication Outputs/ExportSTEP/D14.sldasm
Schémas Electriques/Schémas V3 - Routage/Fabrication Outputs/ExportSTEP/C18.sldasm
Schémas Electriques/Schémas V3 - Routage/Fabrication Outputs/ExportSTEP/Q2.sldasm
Schémas Electriques/Schémas V3 - Routage/Fabrication Outputs/ExportSTEP/R3.sldasm
Schémas Electriques/Schémas V3 - Routage/Fabrication Outputs/ExportSTEP/R2.sldasm
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
