kaostheory78/Projet-Balise/rapports/Projet balise - Gantt.pdf

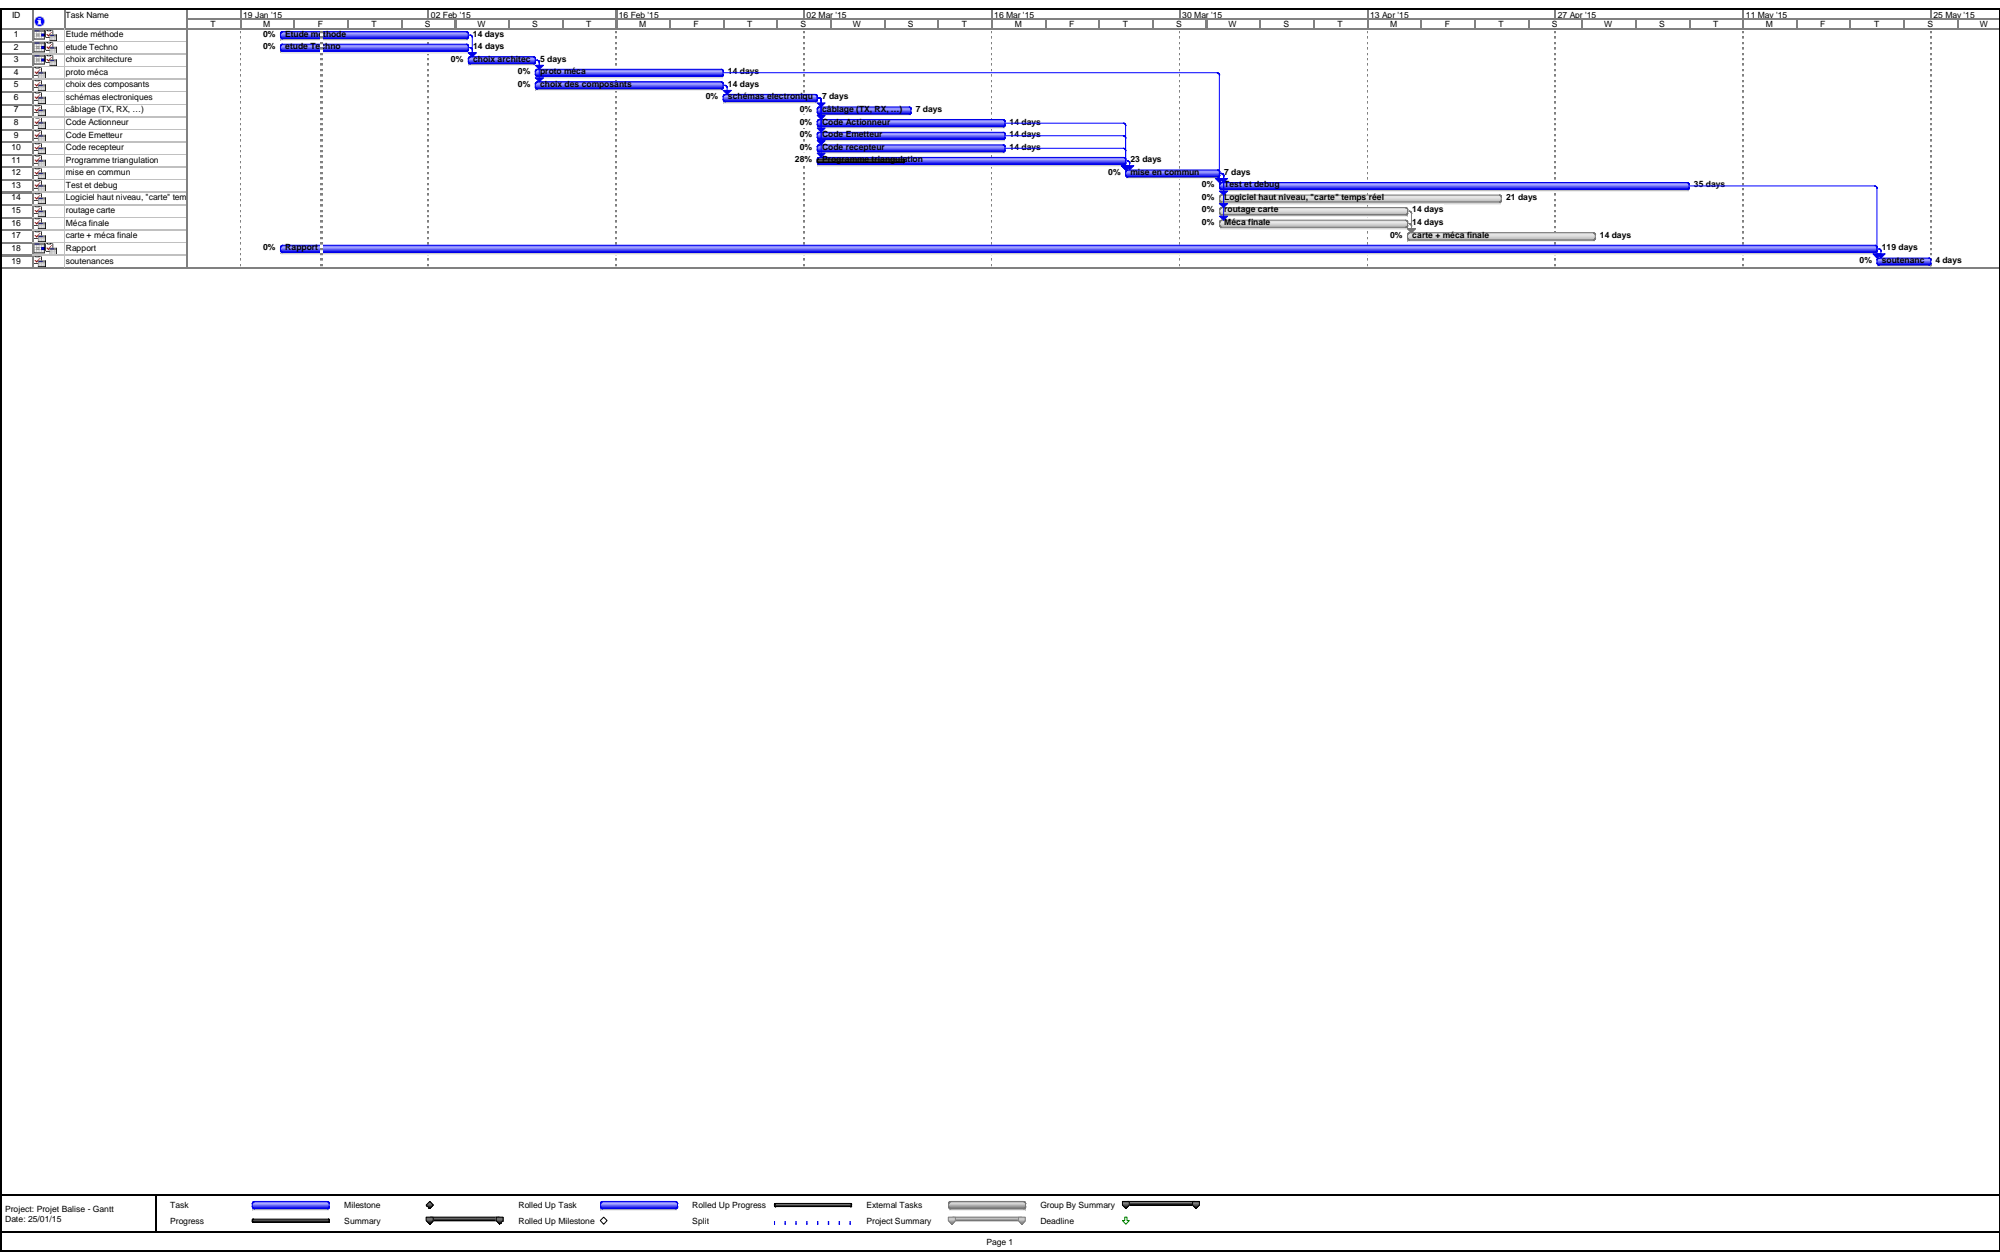
[picture p42: page 1]
0% etude Techno; 14 days; proto méca; câblage (TX, RX, …); 7 days; Code Actionneur; Code Emetteur; Code recepteur; 28% Programme triangulation; 23 days; 0% mise en commun; Test et debug; 35 days; Logiciel haut niveau, "carte" temps réel; 21 days; routage carte; 0% Méca finale; 0% Rapport; 119 days; Task; Progress; Milestone; Summary; External Tasks; Project Summary

ID | | Task Name | | 19 Jan '15 | 02 Feb '15 | 16 Feb '15 | 02 Mar '15 | 16 Mar '15 | 30 Mar '15 | 13 Apr '15 | 27 Apr '15 | 11 May '15 | 25 May '15

1 | | Etude méthode | | 0% Etude méthode | | 14 days | | | | | | | | 4 days
2 | | | etude Techno
3 | | | choix architecture | | | | 0% choix architec 5 days
4 5 | proto méca choix des composants | 0% choix des composants | 14 days

6 | schémas electroniques | 0% schémas electroniqu 7 days
7 | câblage (TX, RX, …)
8 | Code Actionneur
9 | Code Emetteur
10 | Code recepteur
11 | Programme triangulation
12 | mise en commun
13 | Test et debug
14 | Logiciel haut niveau, "carte" temps réel | | | 14 days
15 | routage carte | | 0% carte + méca finale
16 | Méca finale
17 | carte + méca finale
18 | Rapport
19 | soutenances | | | 0% soutenanc

Project: Projet Balise - Gantt
Date: 25/01/15

Rolled Up Task
Rolled Up Milestone

Rolled Up Progress
Split

Group By Summary
Deadline

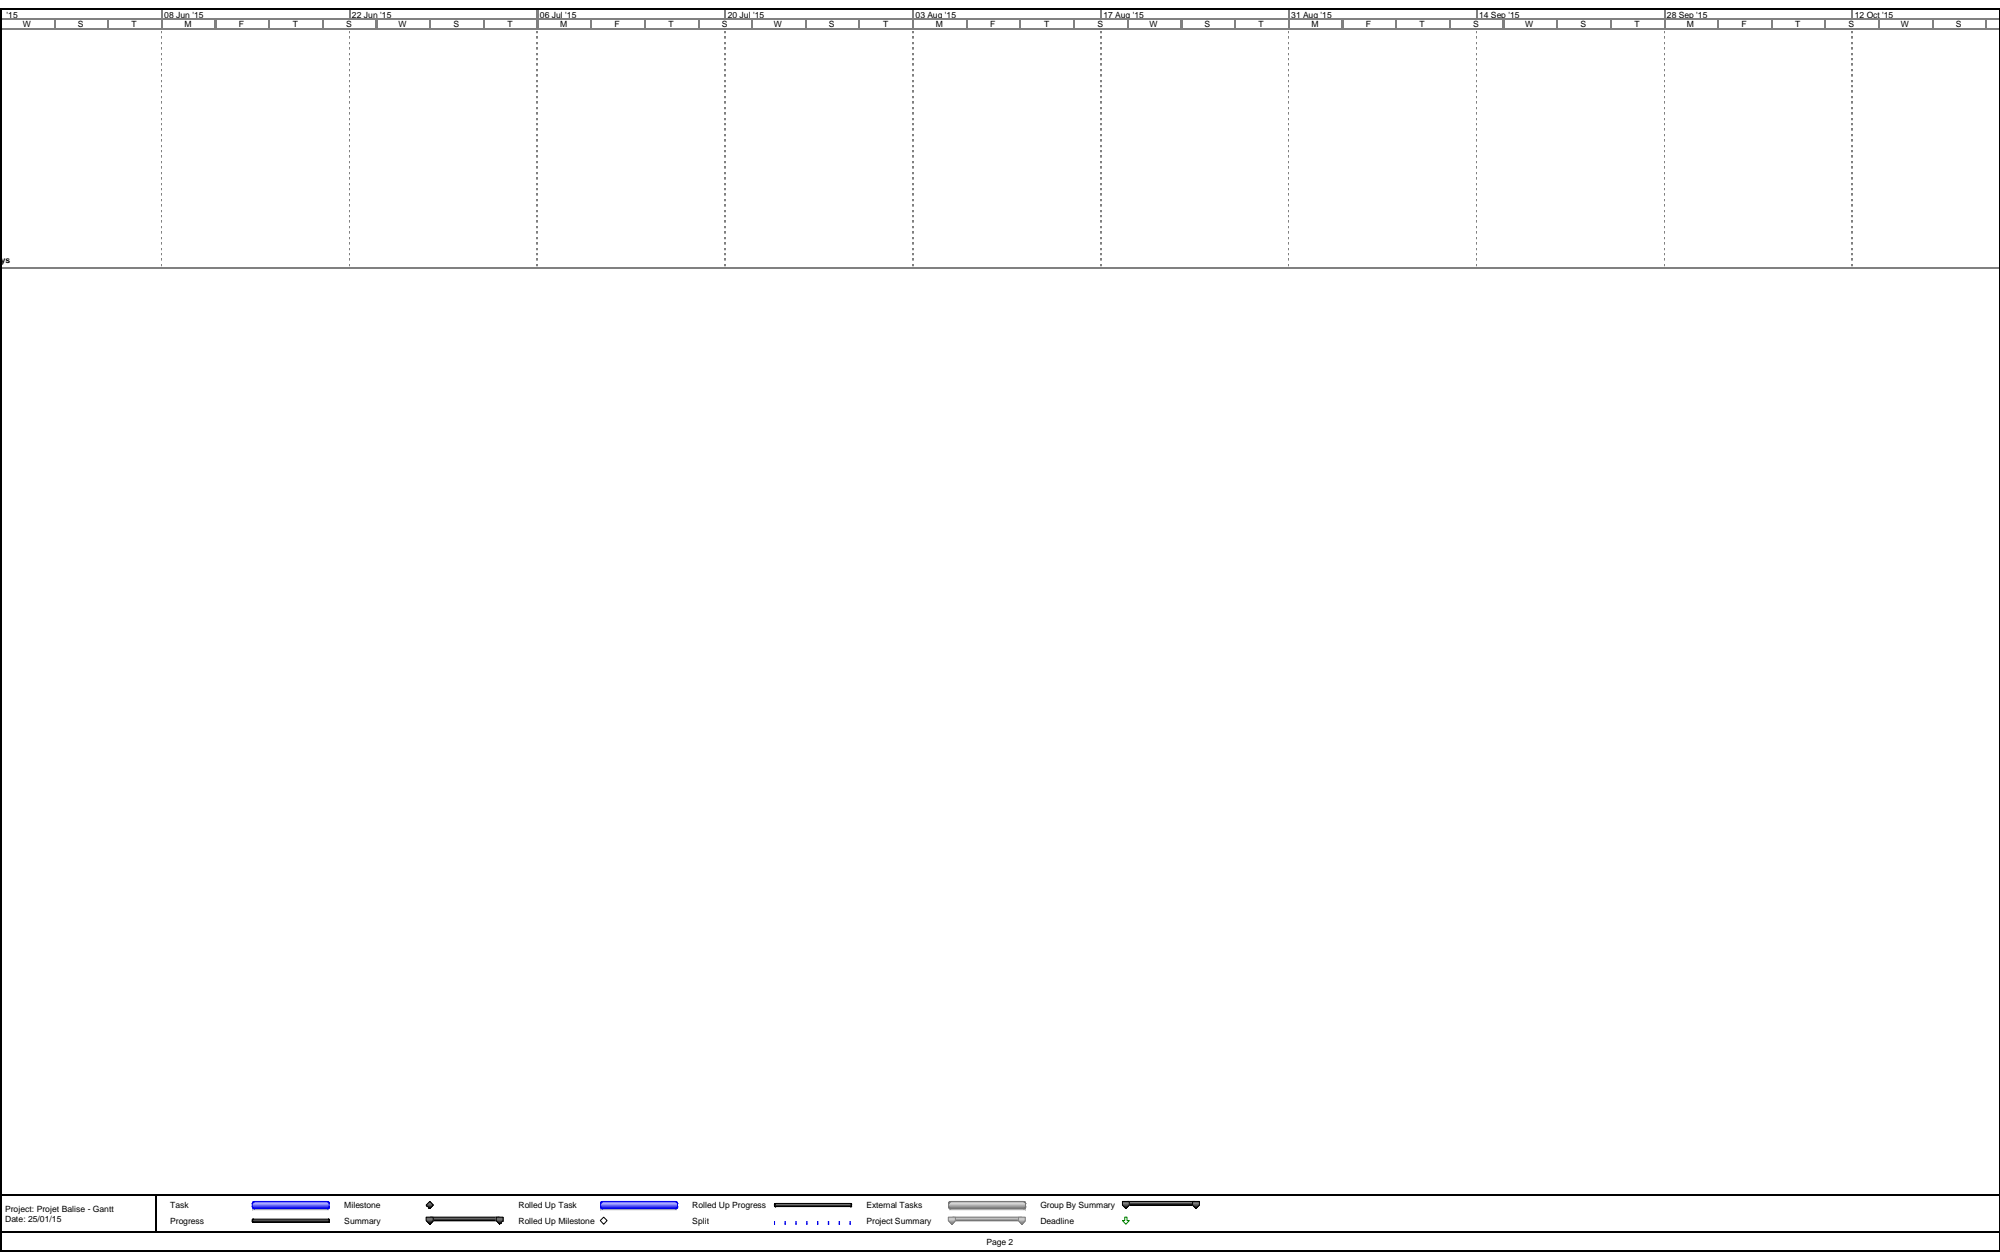
[picture p43: page 2]
Task; Progress; Milestone; Summary; External Tasks; Project Summary

'15 | 08 Jun '15 | 22 Jun '15 | 06 Jul '15 | 20 Jul '15 | 03 Aug '15 | 17 Aug '15 | 31 Aug '15 | 14 Sep '15 | 28 Sep '15 | 12 Oct '15

Project: Projet Balise - Gantt
Date: 25/01/15

Rolled Up Task
Rolled Up Milestone

Rolled Up Progress
Split

Group By Summary
Deadline
