kaostheory78/Projet-Balise/Schémas Electriques/Schémas V3 - Routage/Fabrication Outputs/Carte Balise.PDF

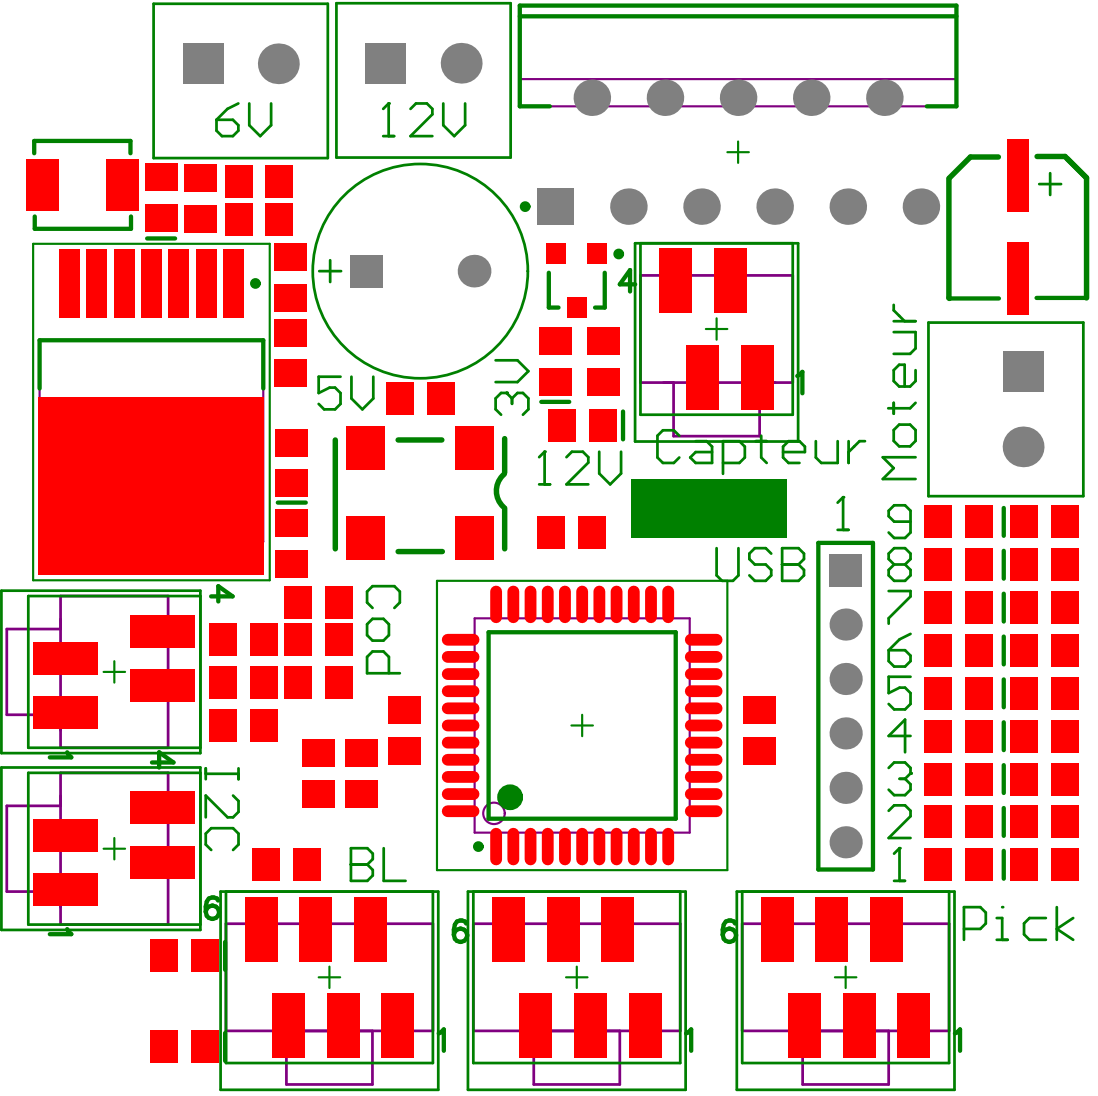
[picture p44: page 1]

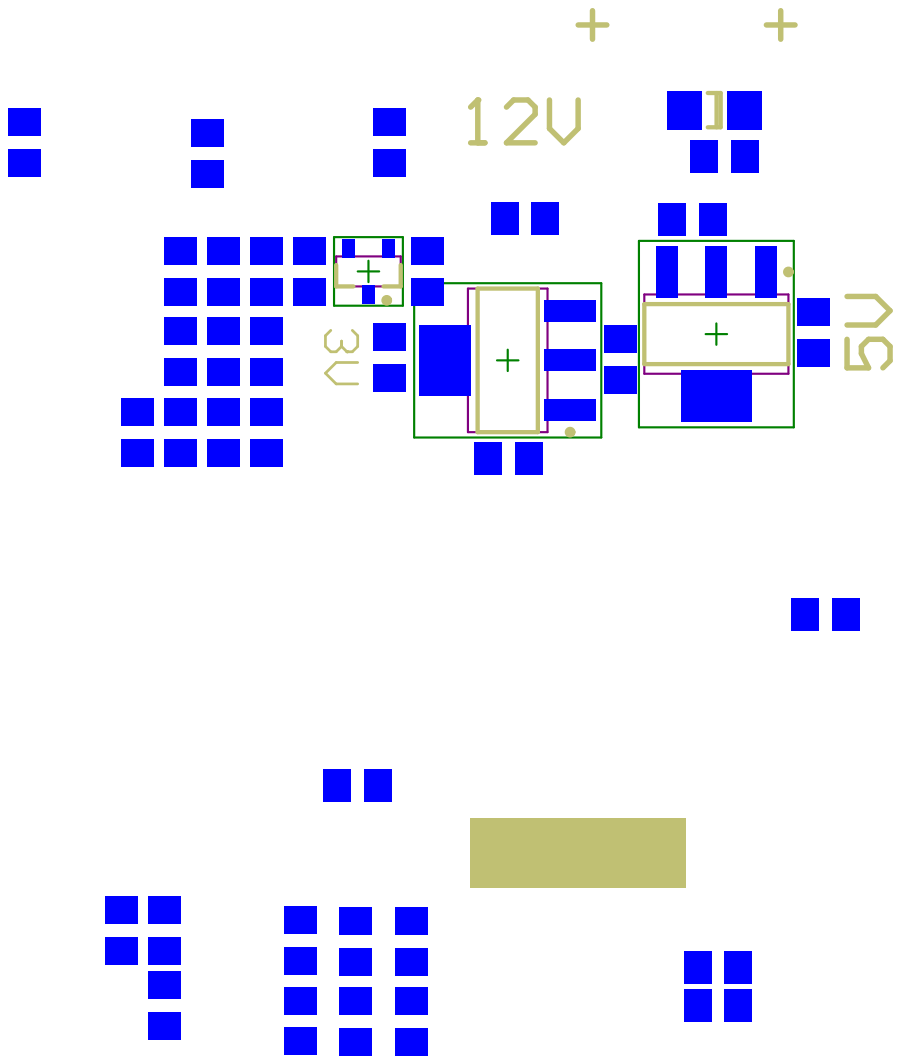
[picture p45: page 2]

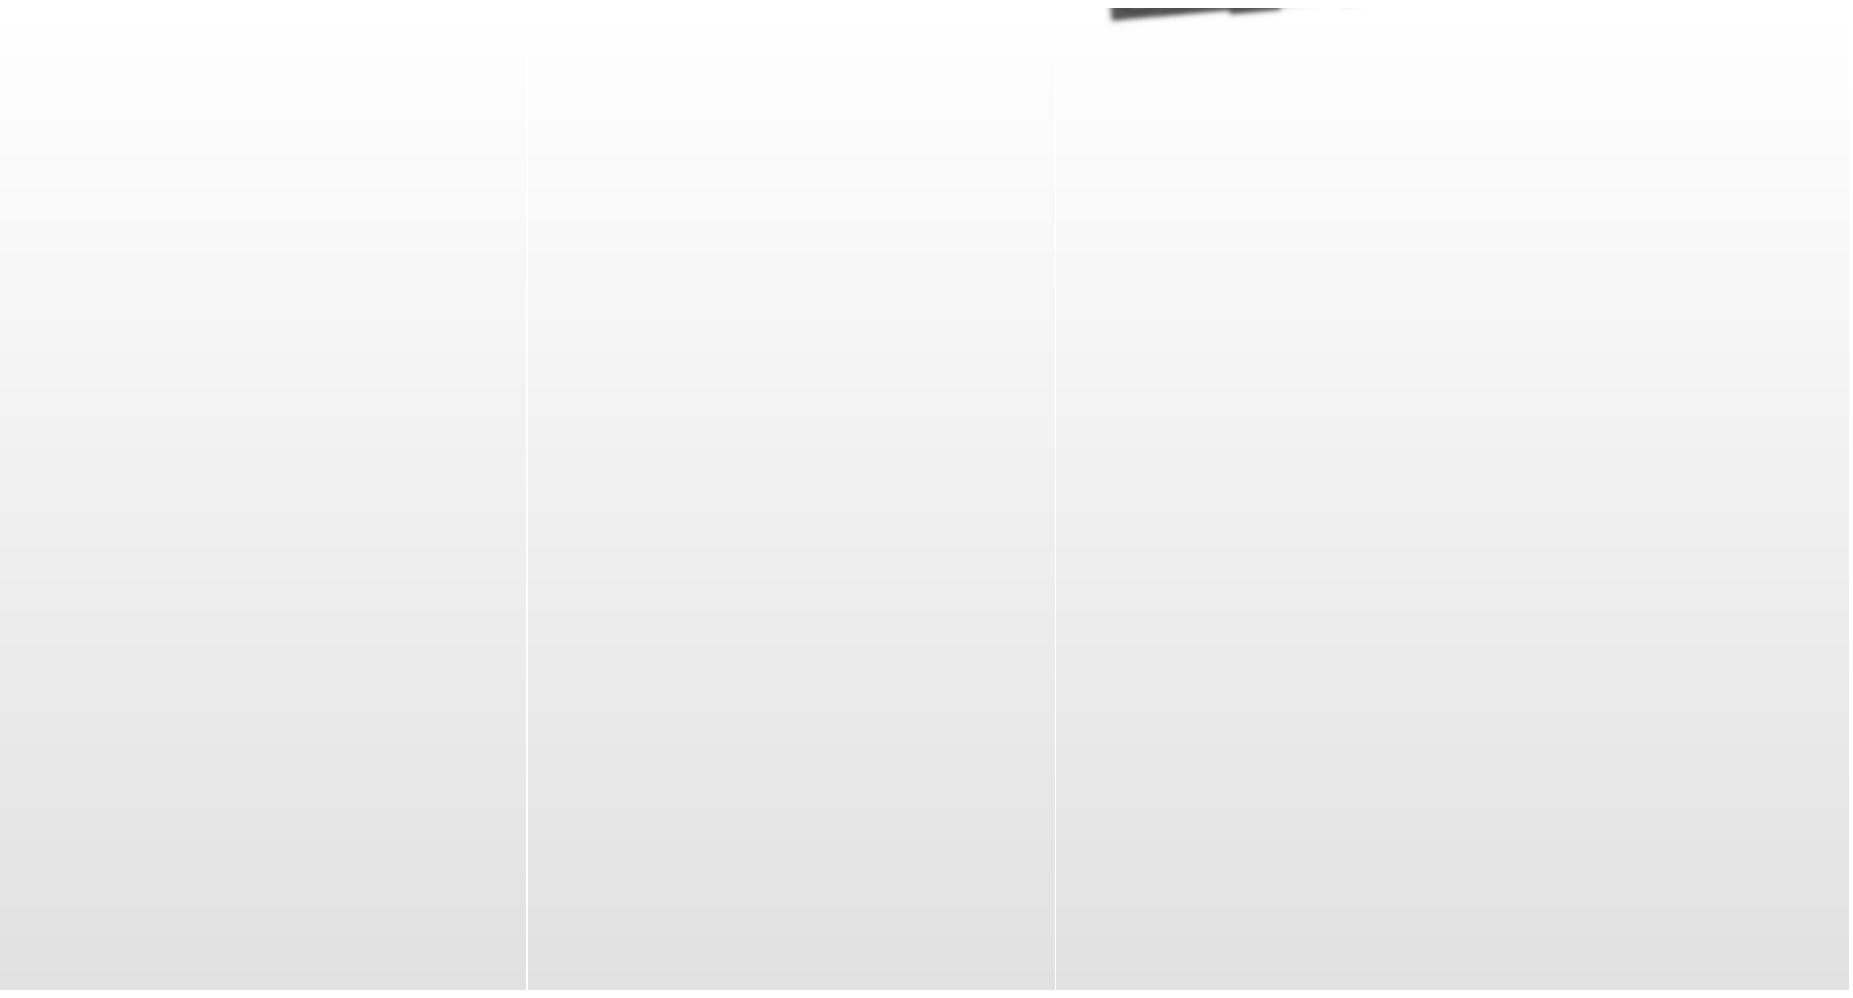
[picture p46: page 3]
