kaostheory78/Projet-Balise/Schémas Electriques/Schémas V3 - Routage/Fabrication Outputs/Schematic Prints.PDF

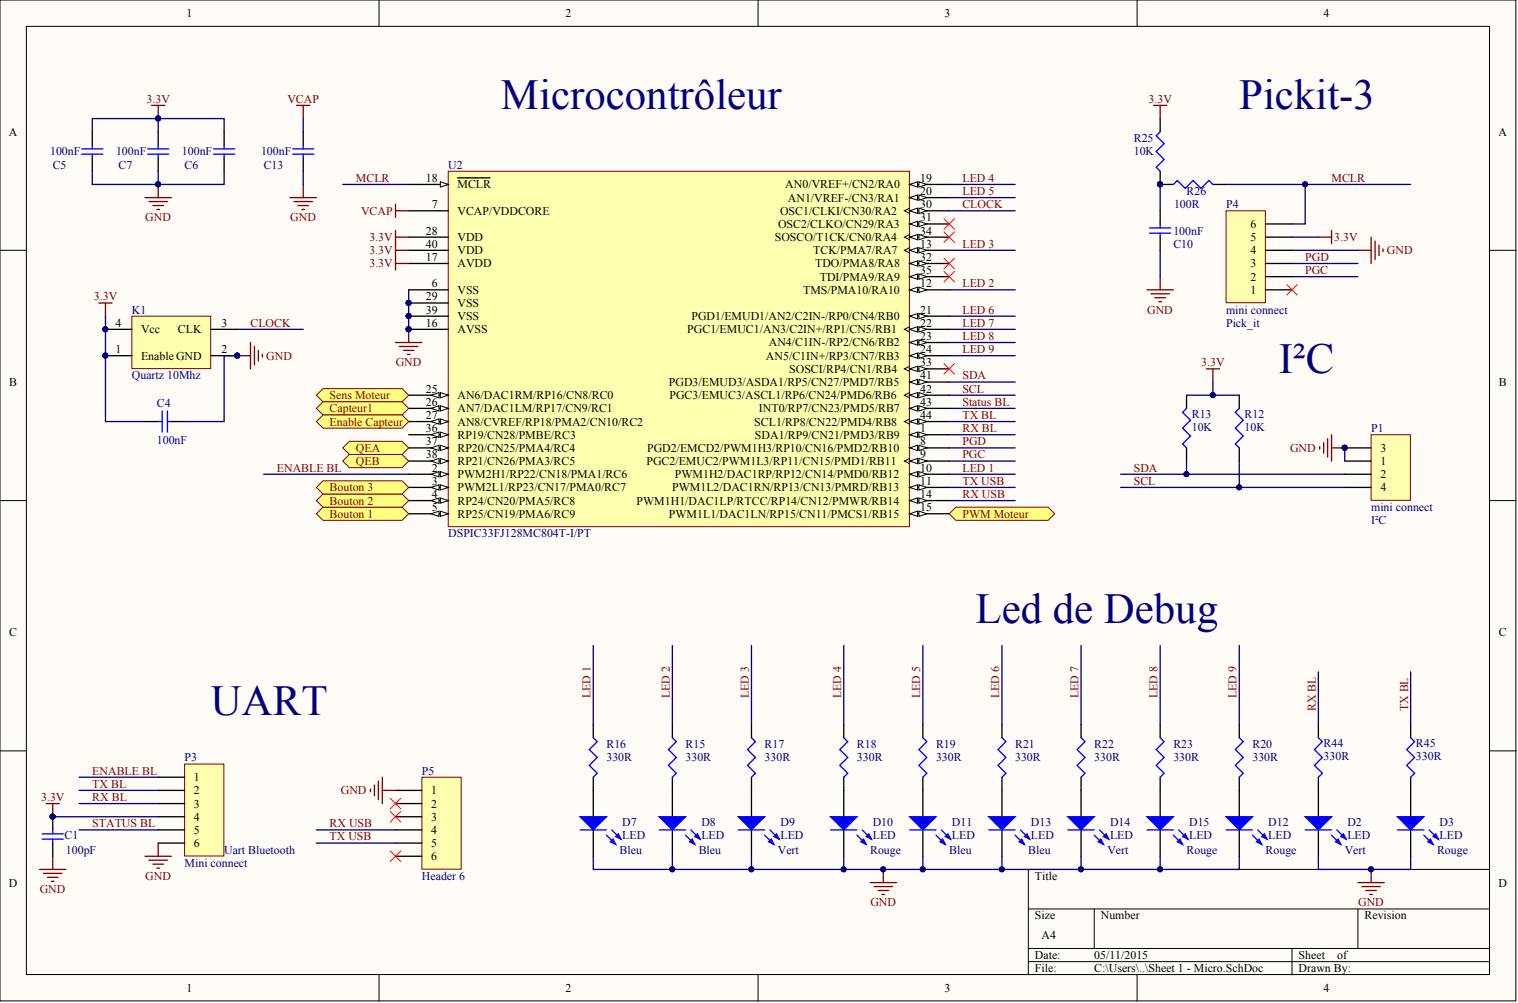
[picture p47: page 1]

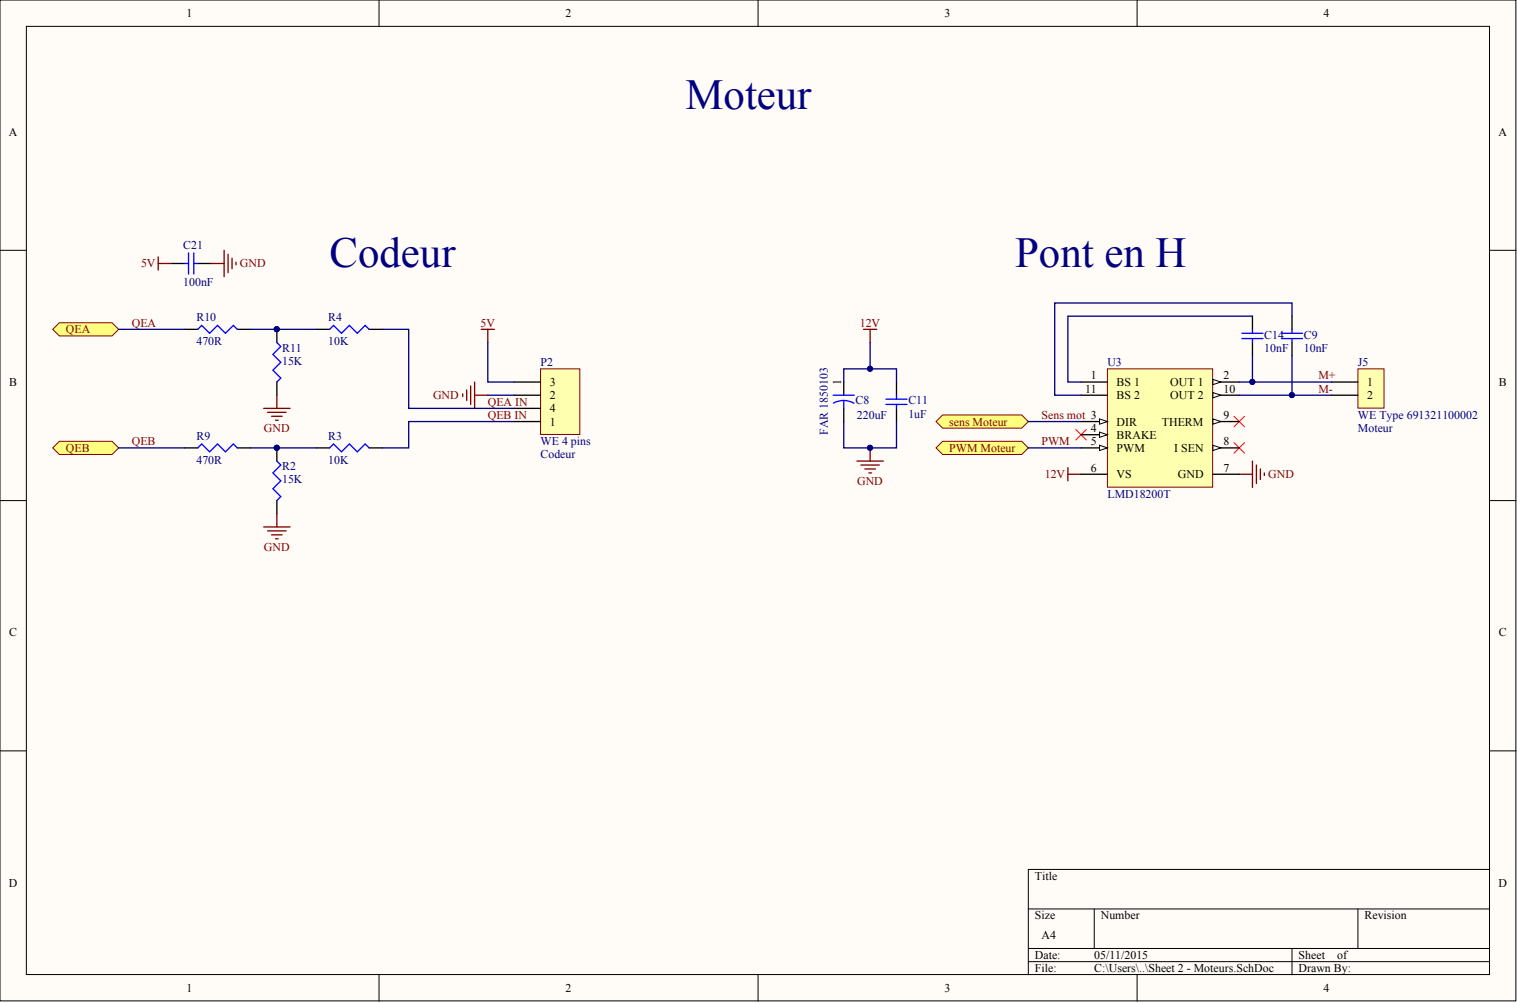
[picture p48: page 2]

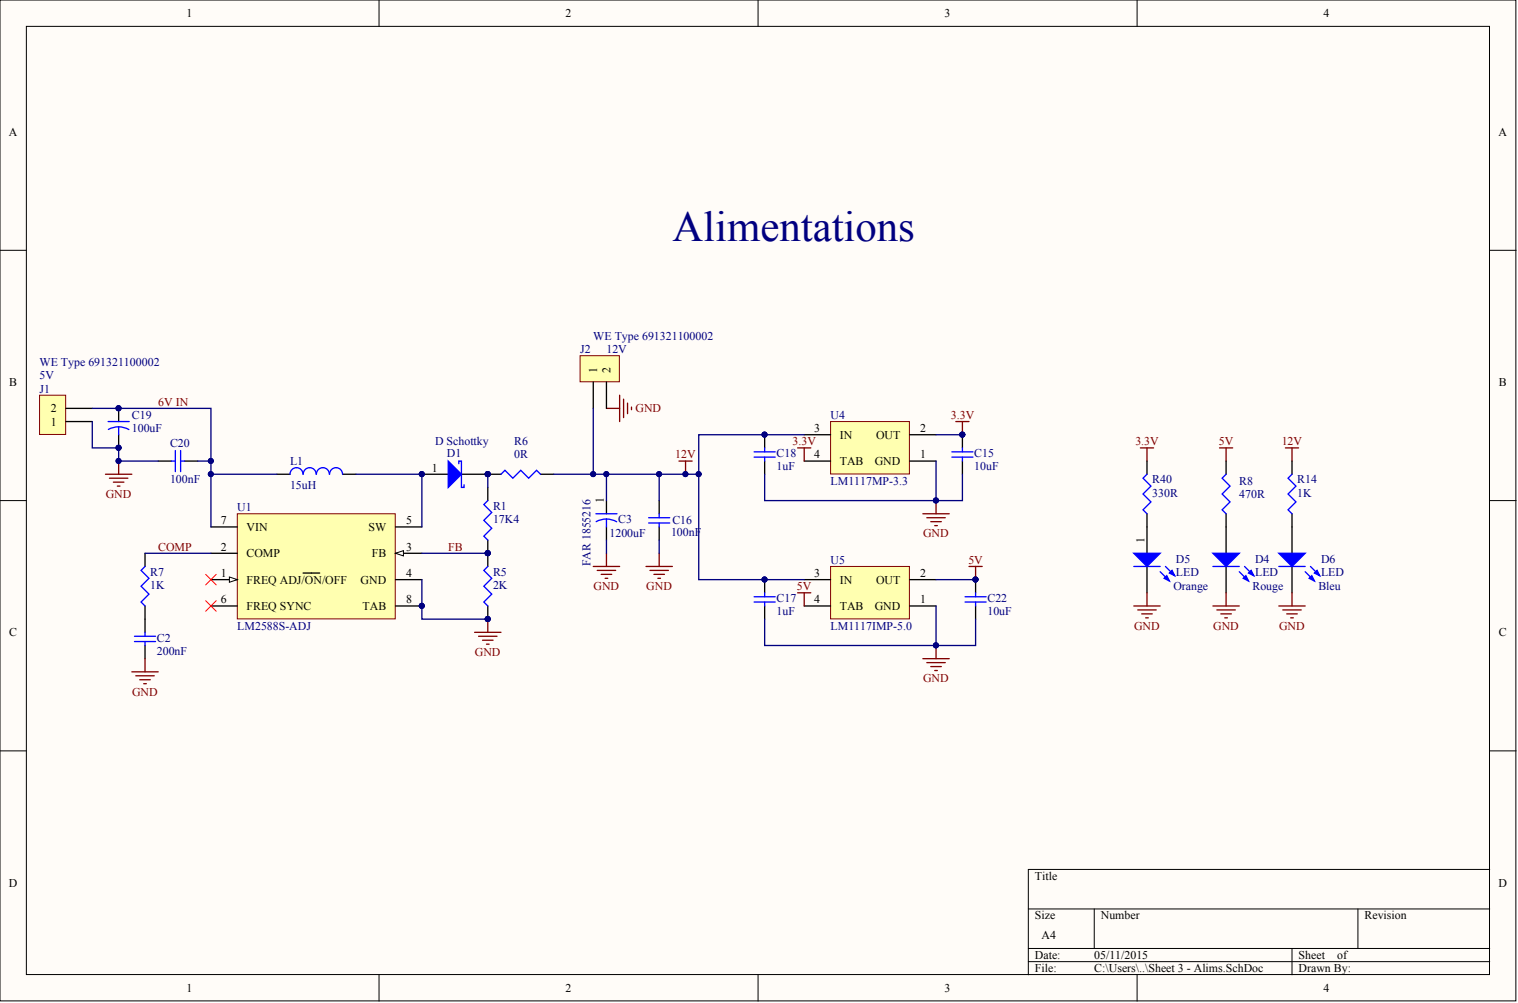
[picture p49: page 3]

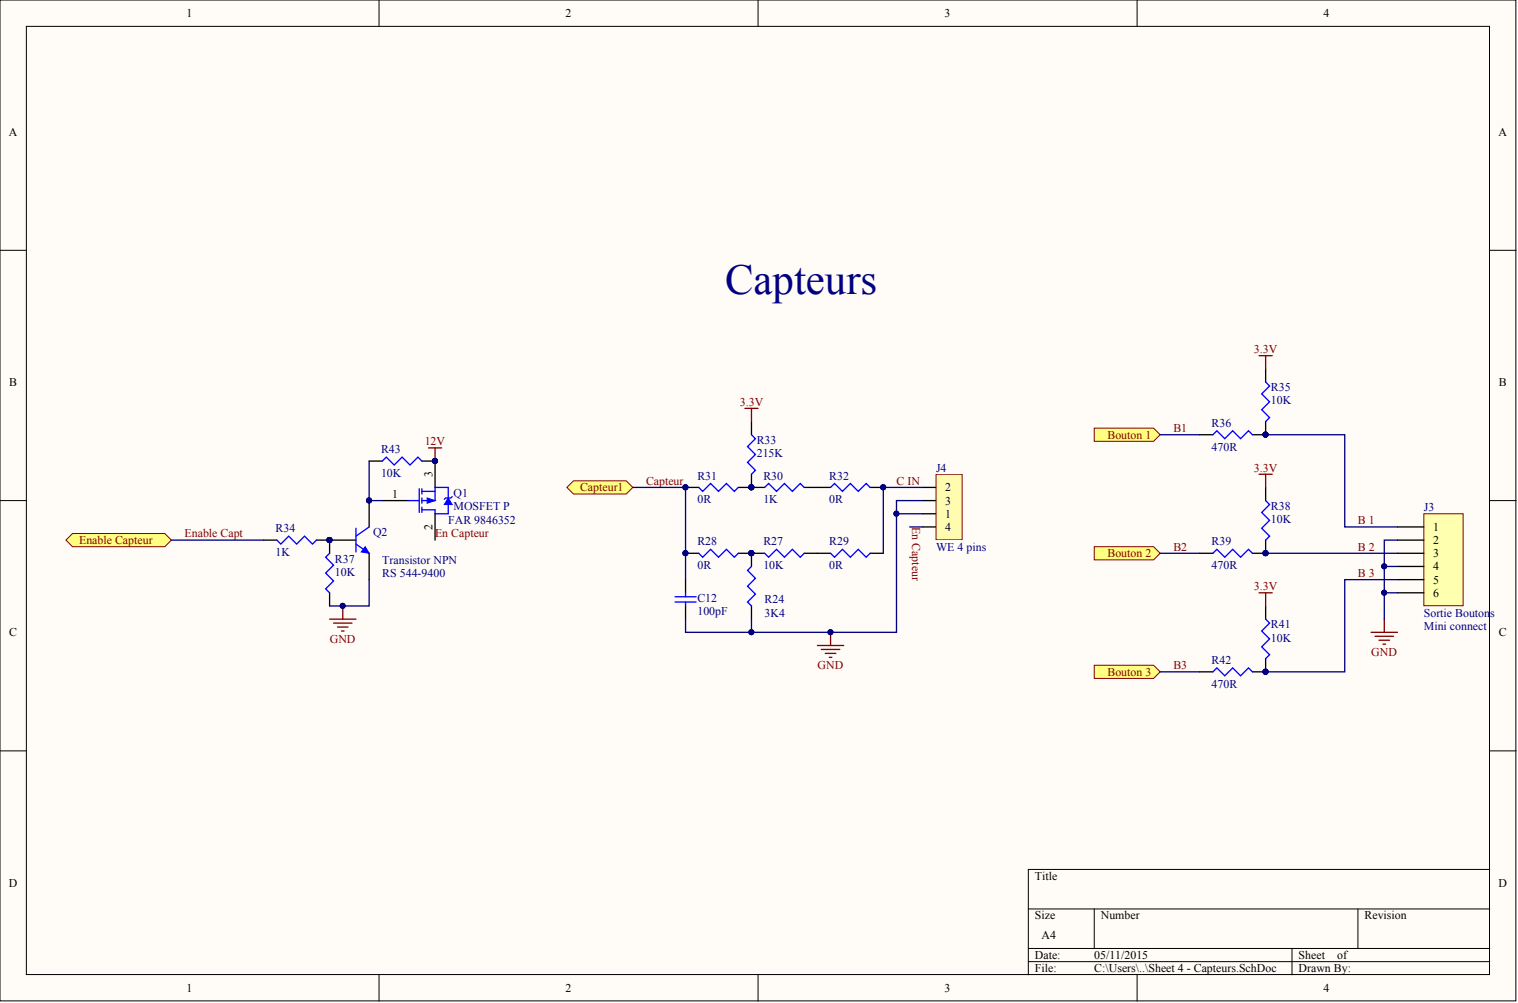
[picture p50: page 4]
