kaostheory78/Projet-Balise/Schémas Electriques/Schémas V3 - Routage/Fabrication Outputs/Standard.PDF

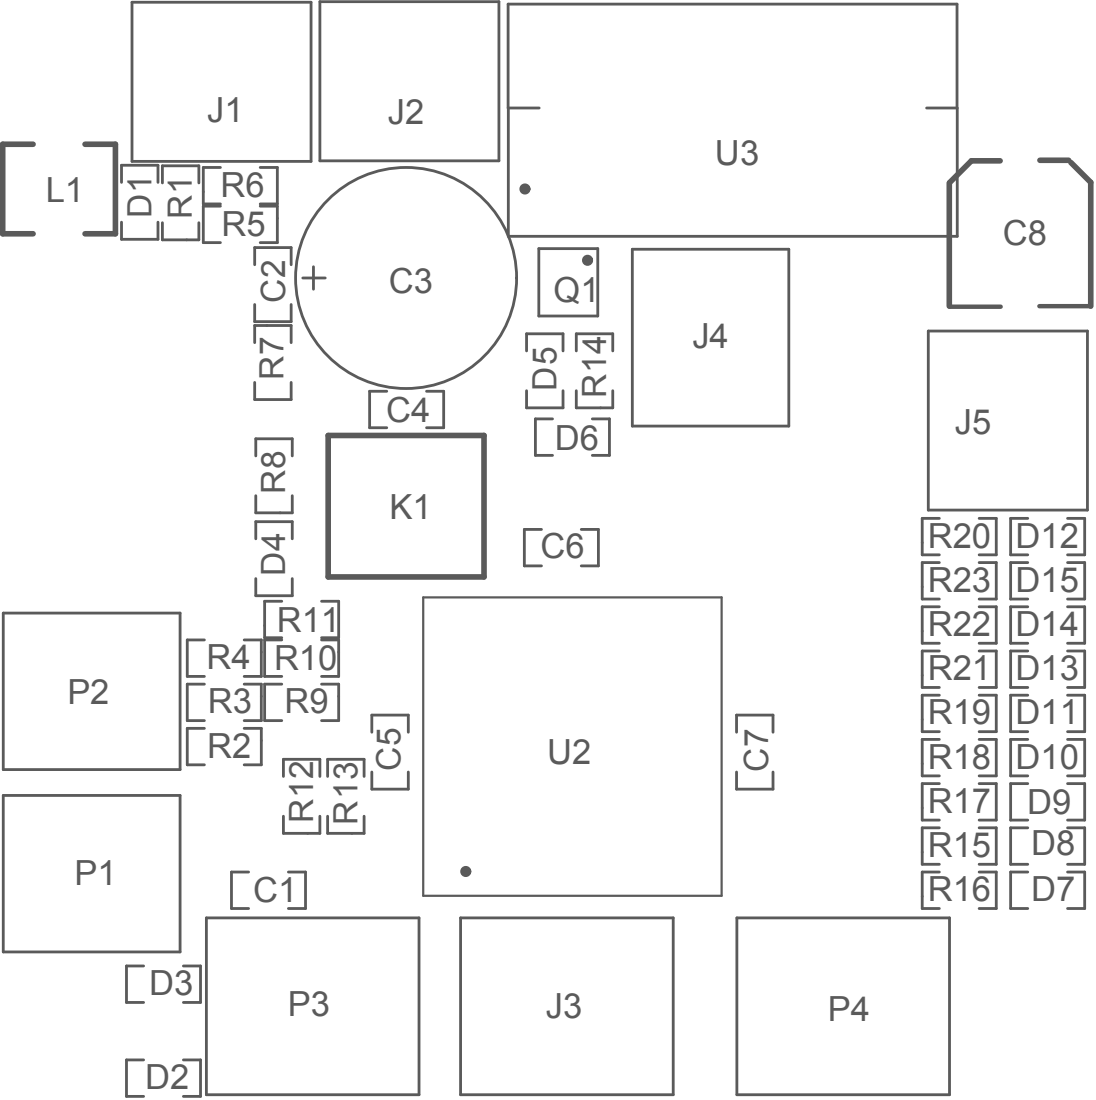
[picture p51: page 1]

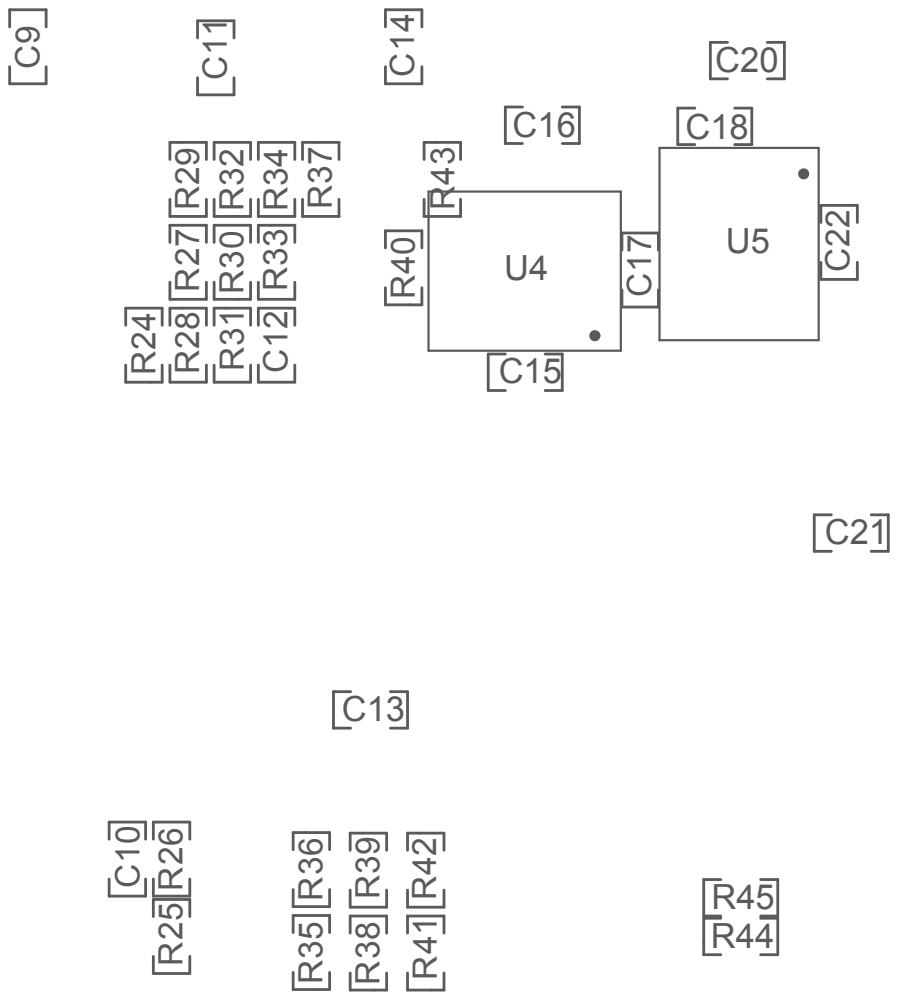
[picture p52: page 2]

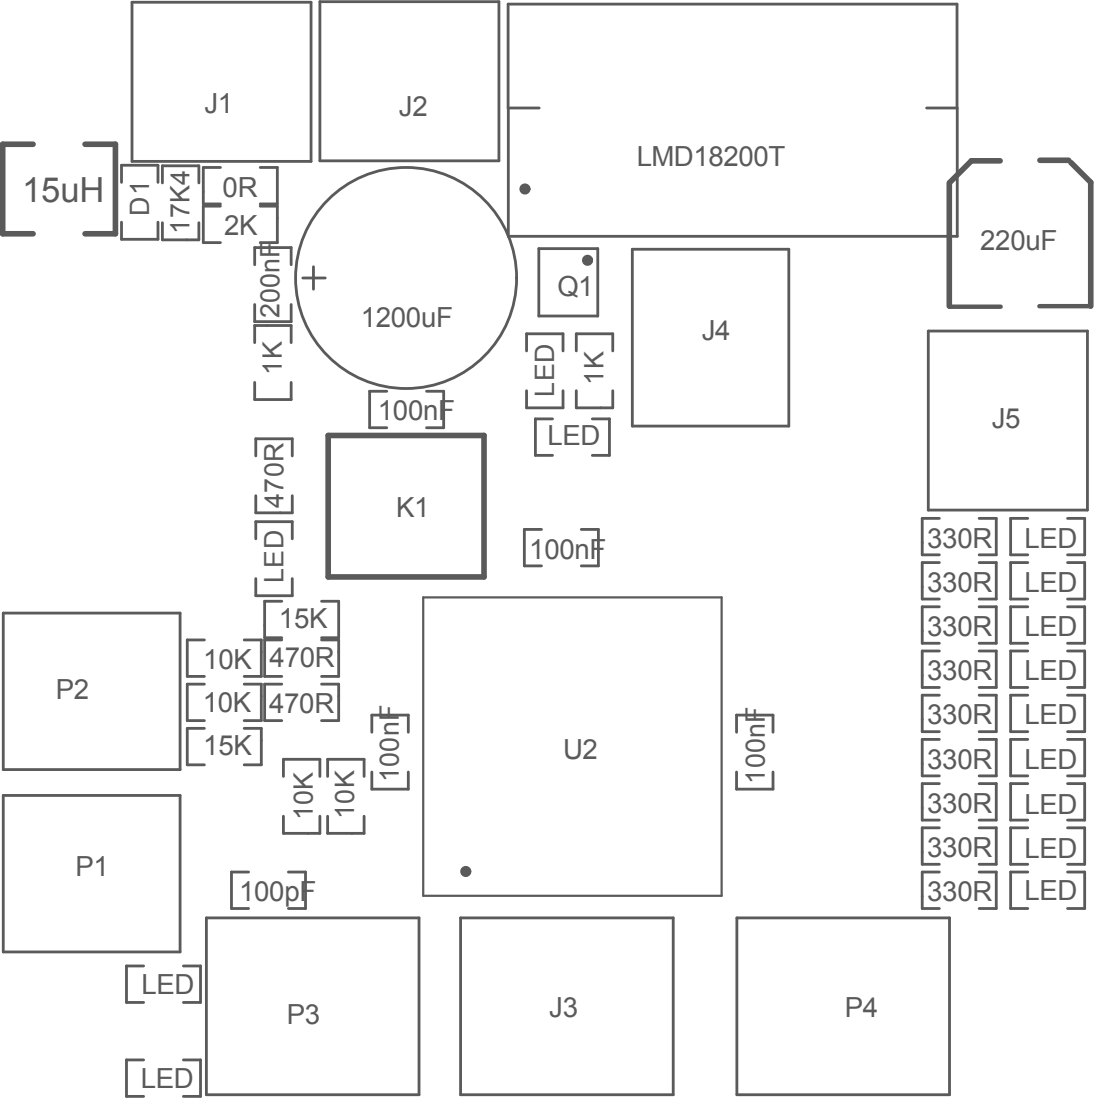
[picture p53: page 3]

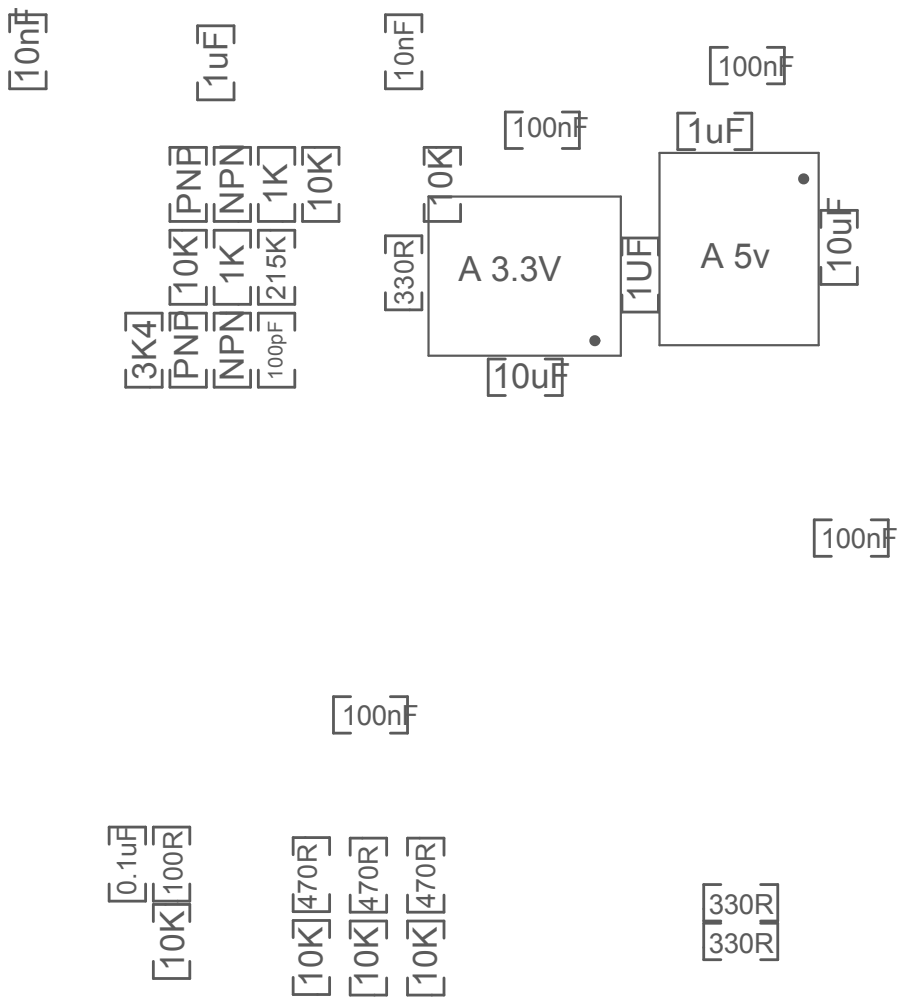
[picture p54: page 4]
