kaostheory78/Projet-Balise/Schémas Electriques/Schémas V2 - wrapping/Schémas V2 - sheets.pdf

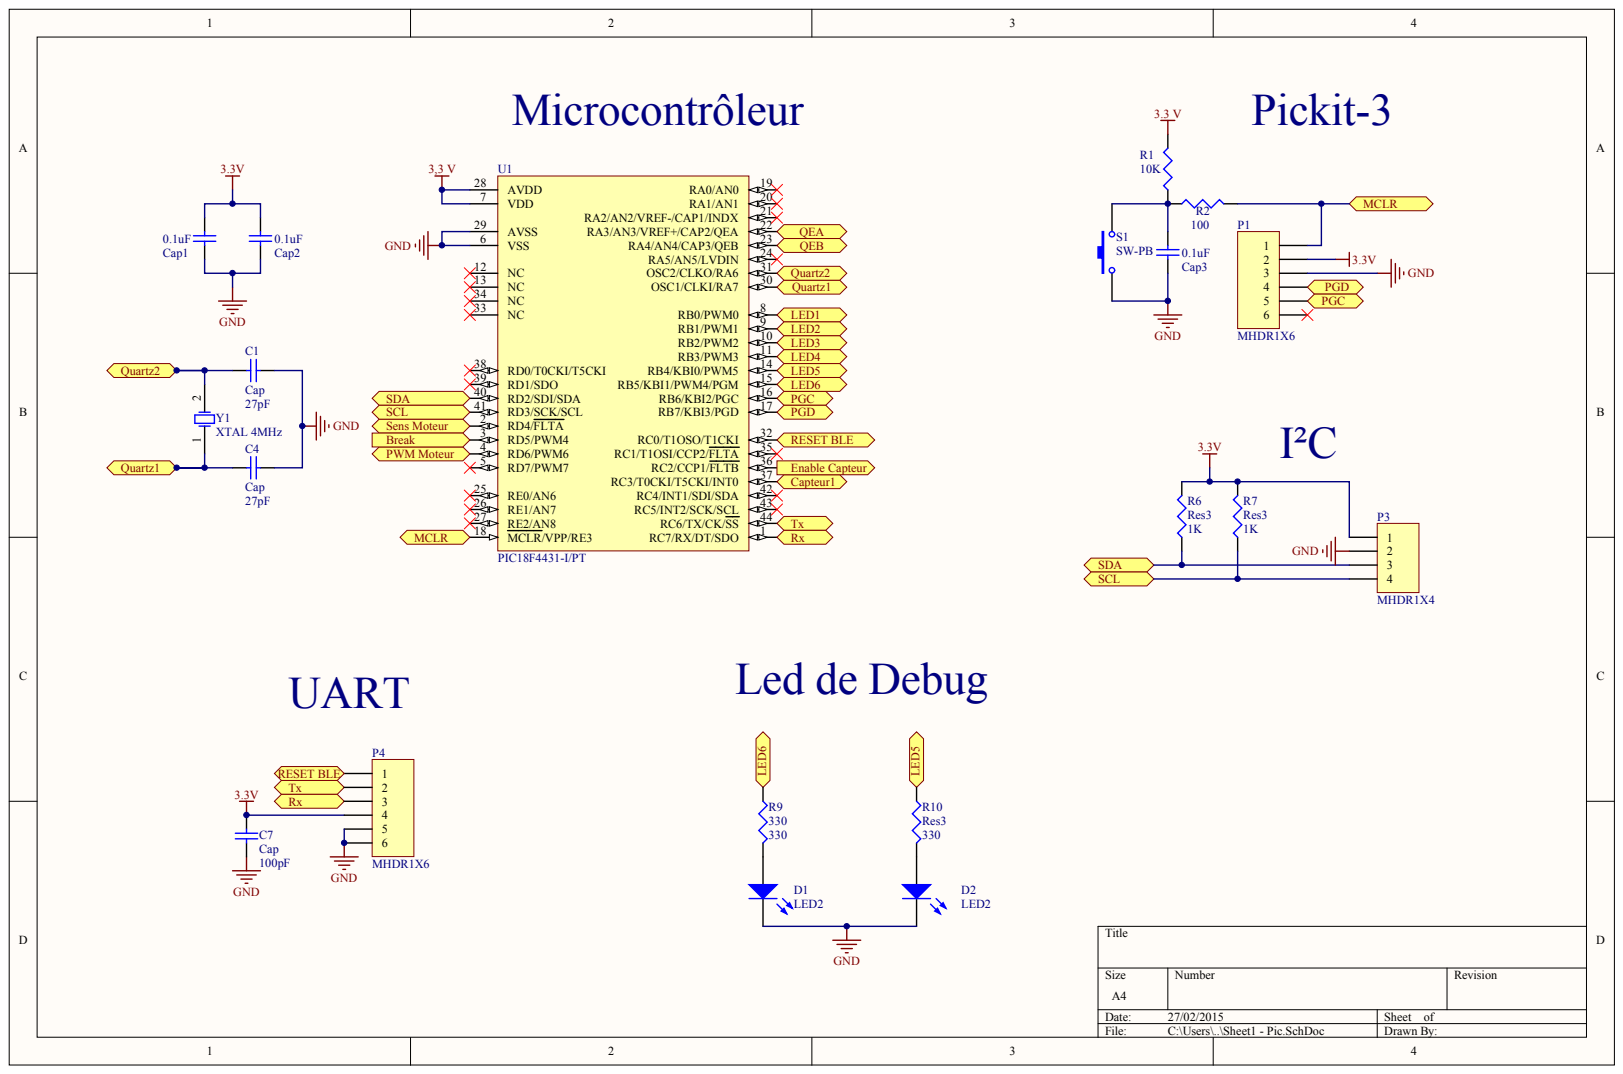
[picture p55: page 1]

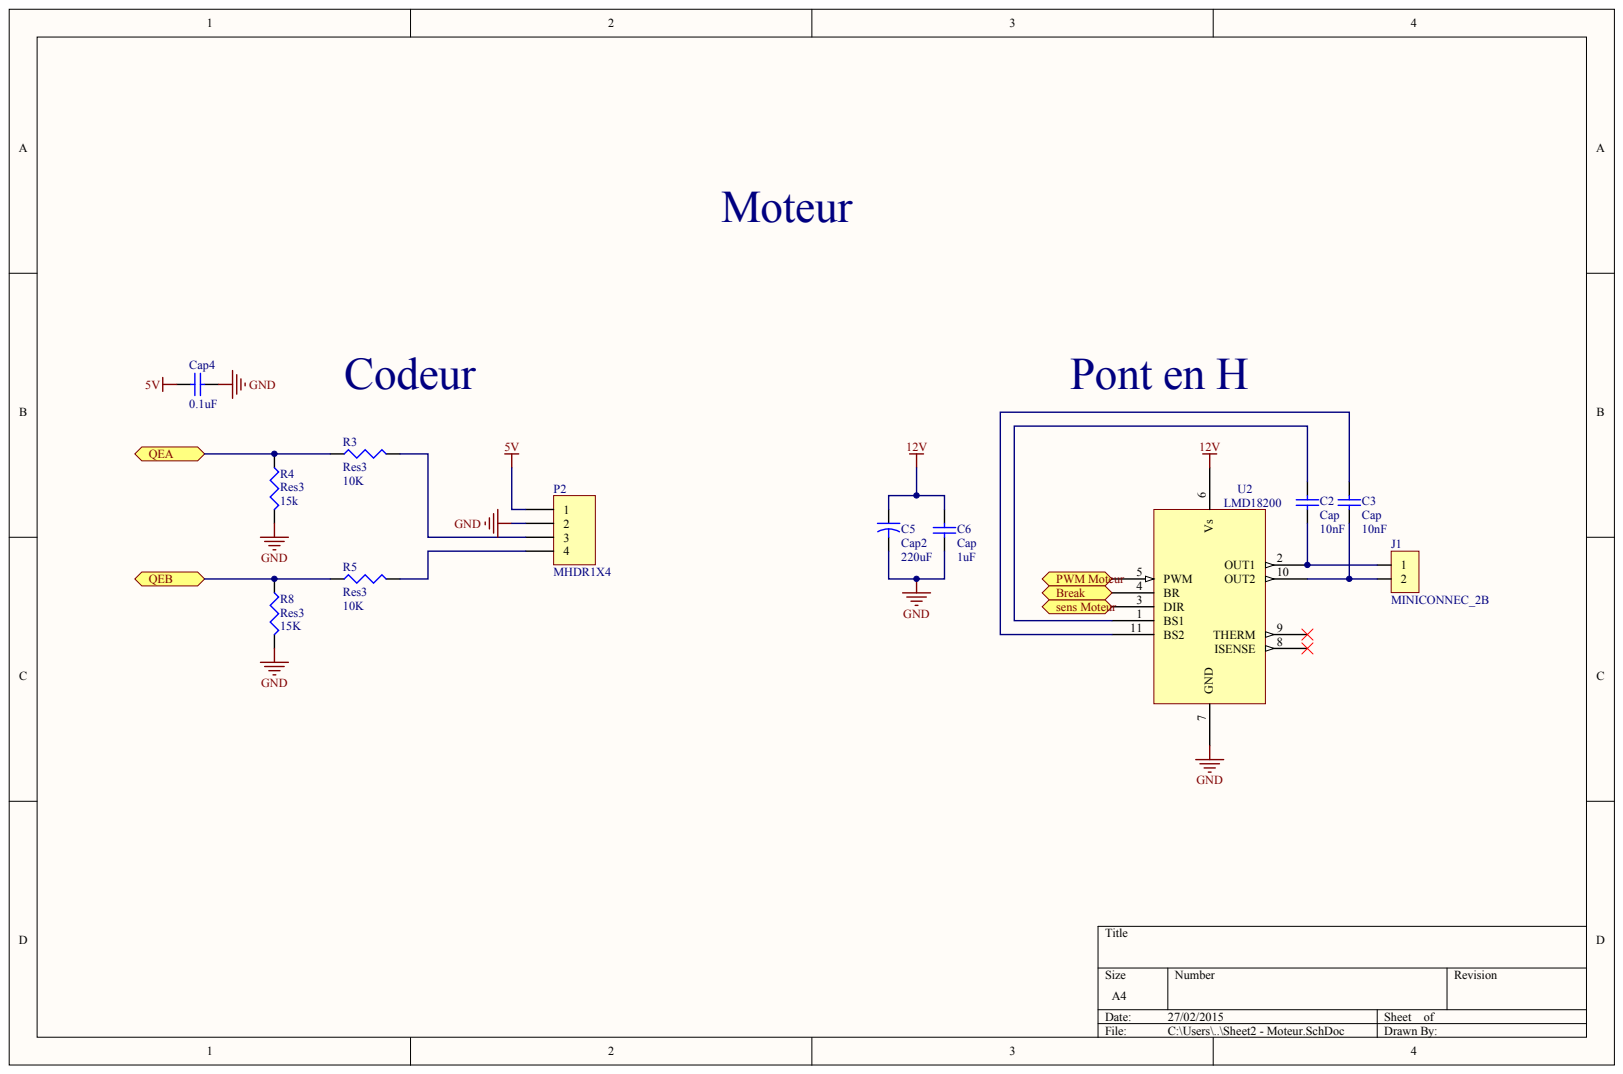
[picture p56: page 2]

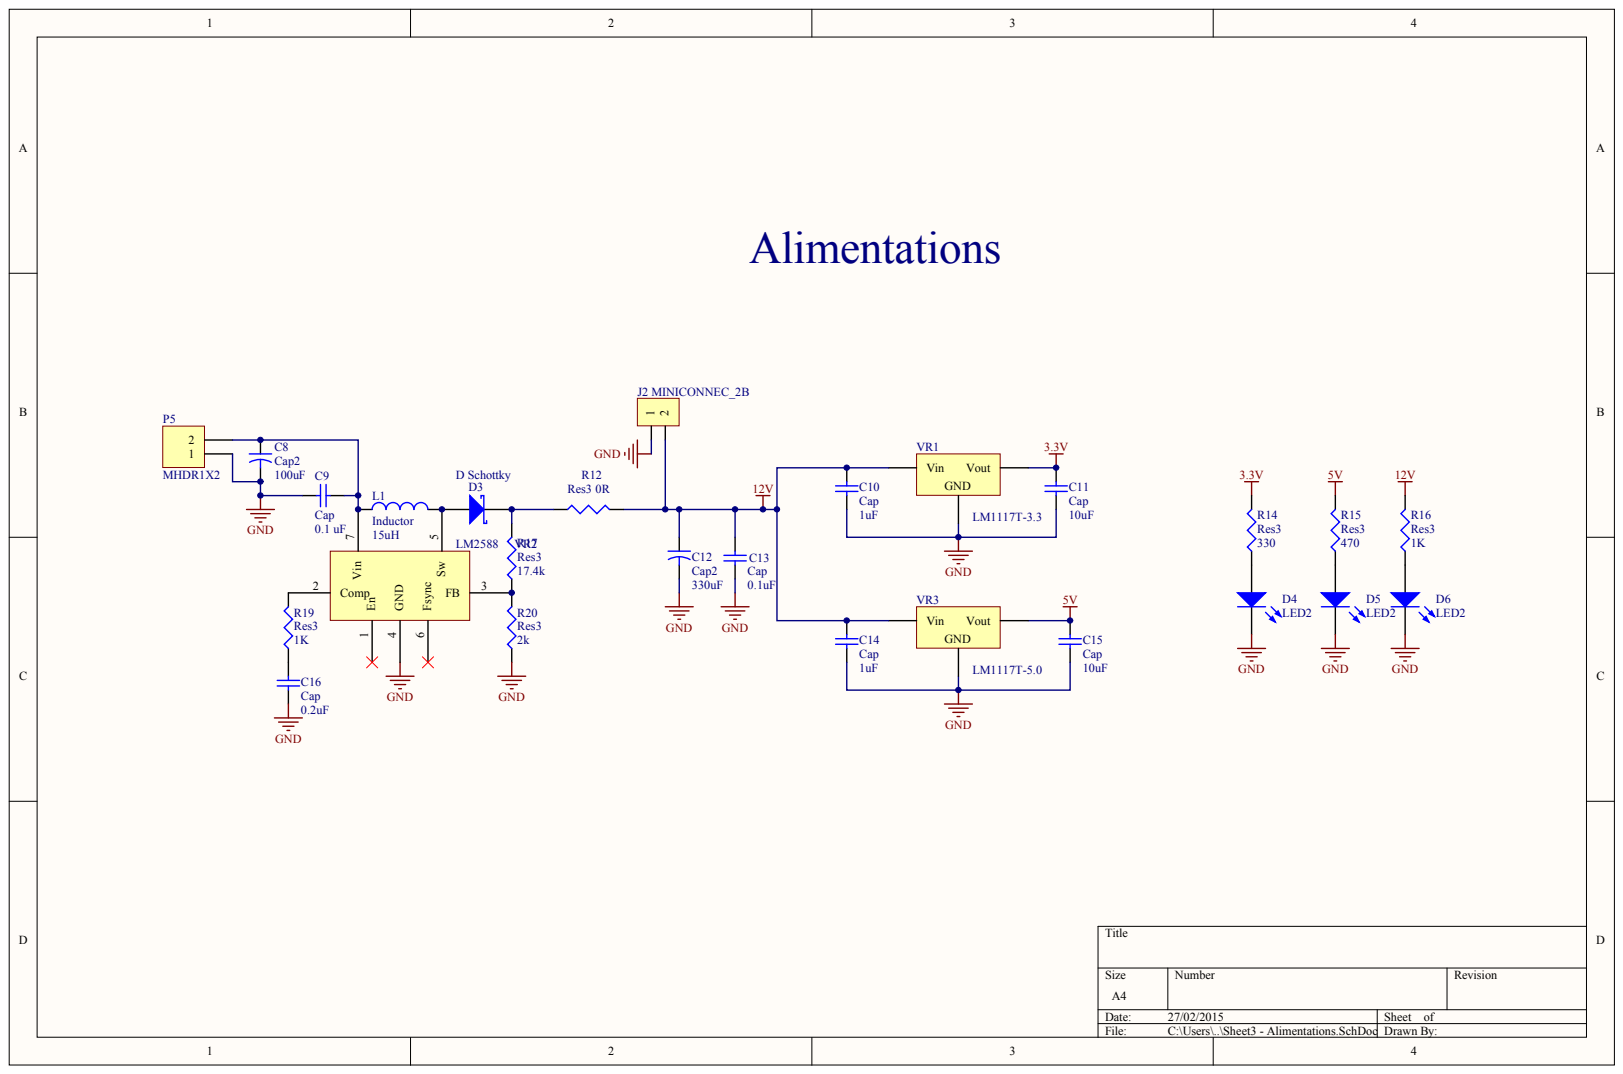
[picture p57: page 3]

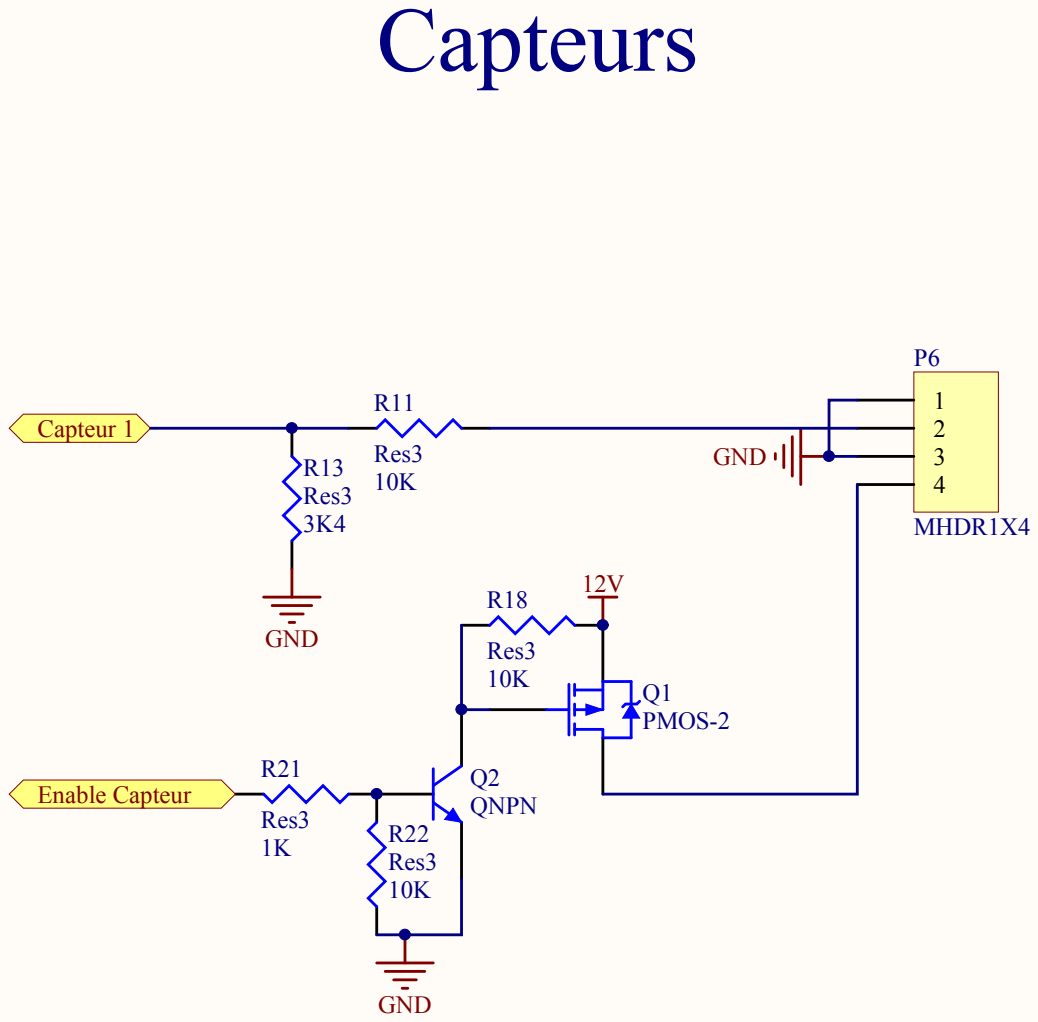
[picture p58: page 4]

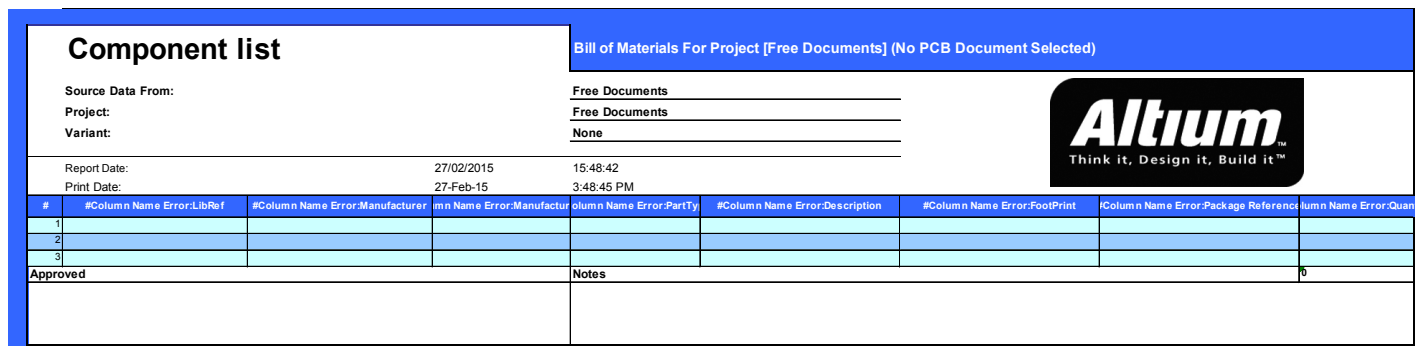
[picture p59: page 5]

Approved | Notes | 0
