kaostheory78/Projet-Balise/Schémas Electriques/Schémas V1/Schémas V1.pdf

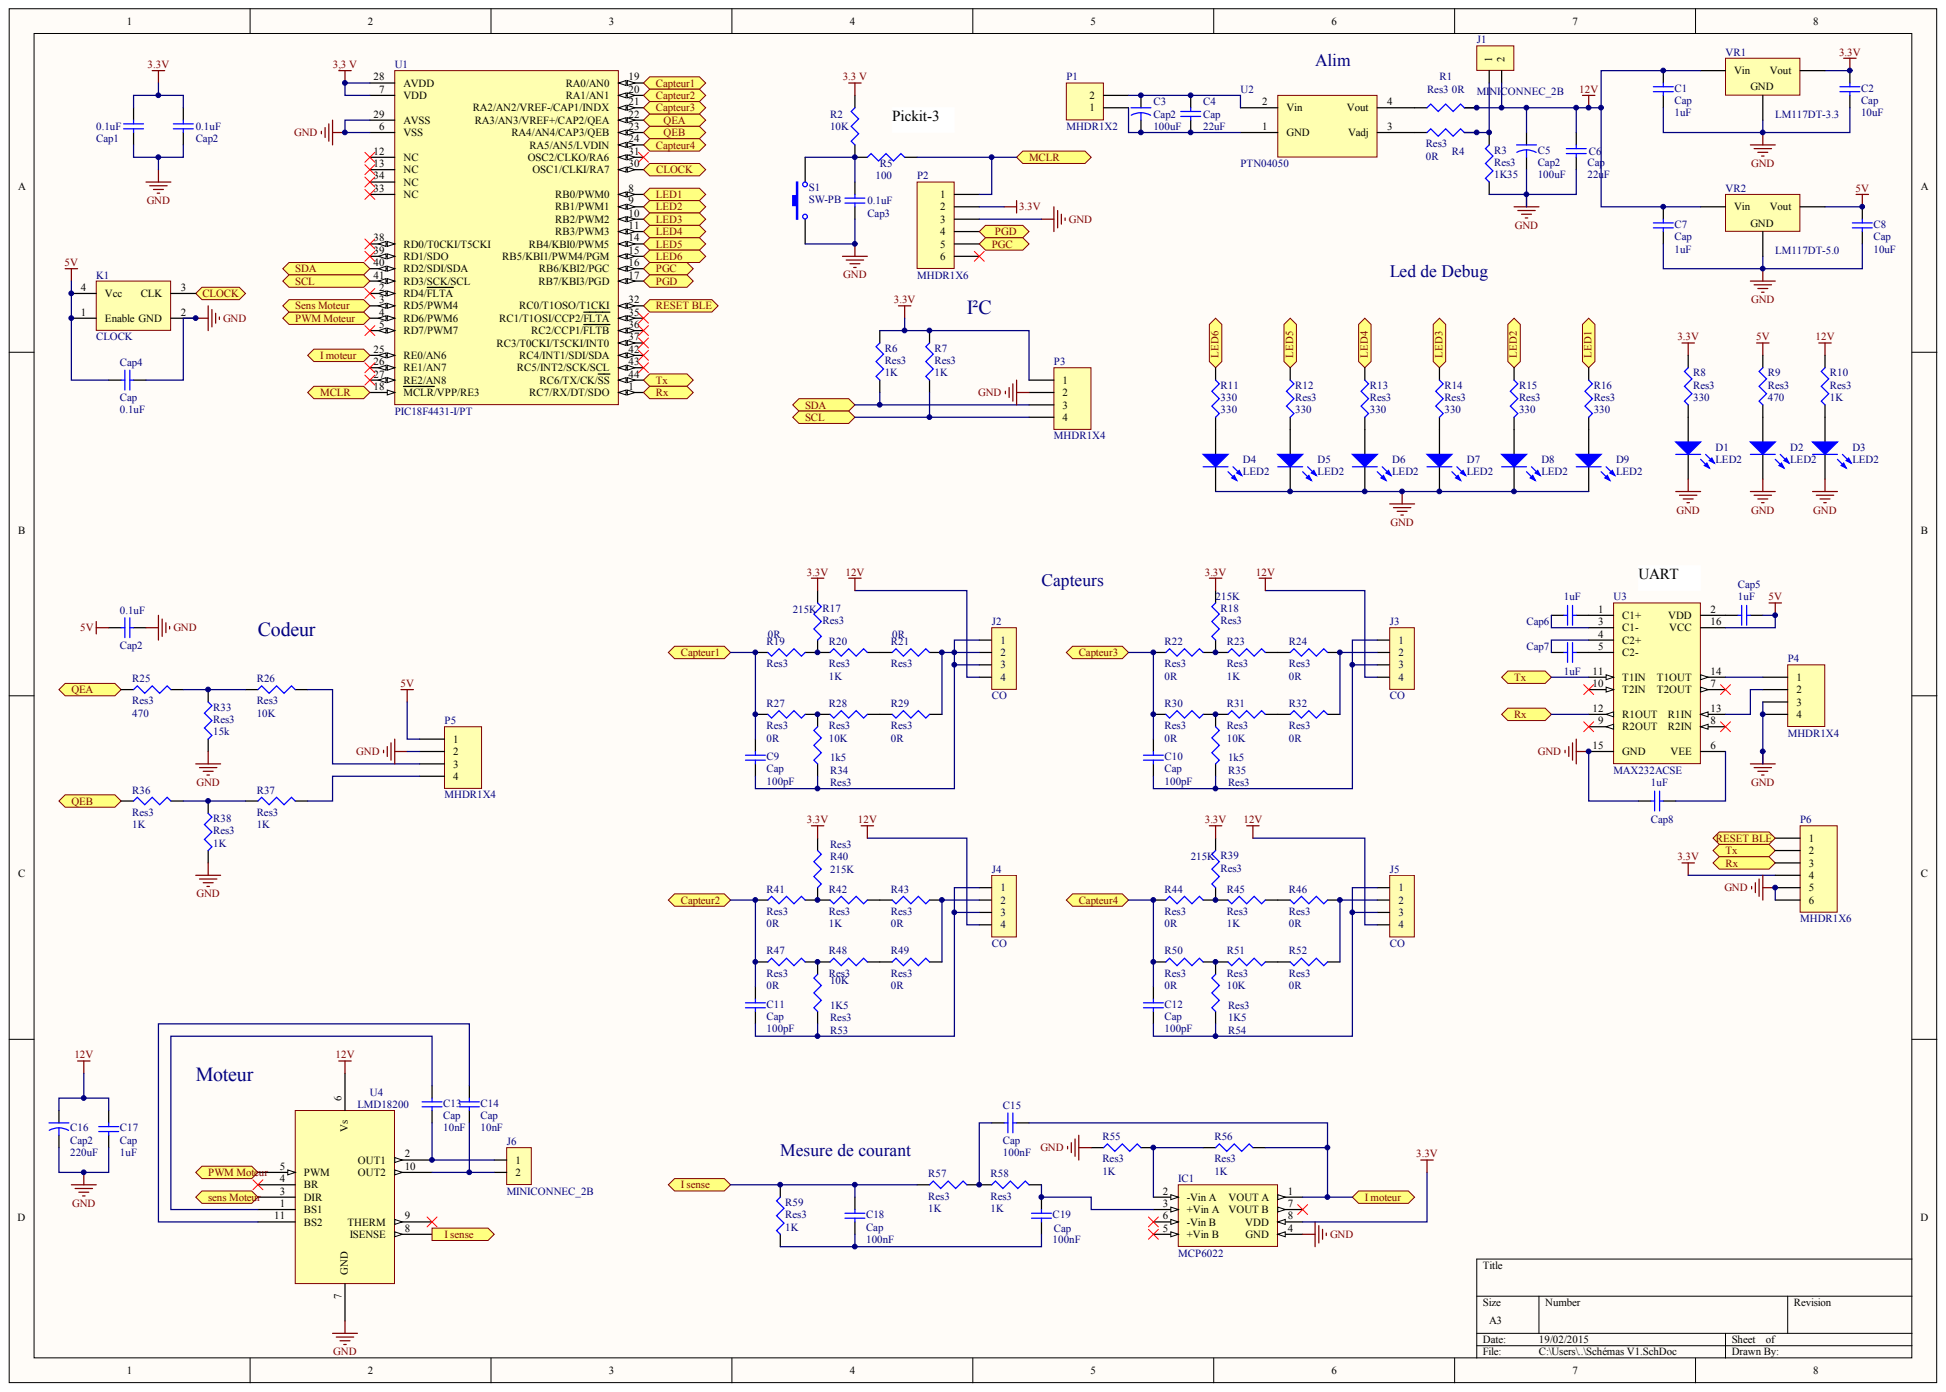
[picture p60: page 1]

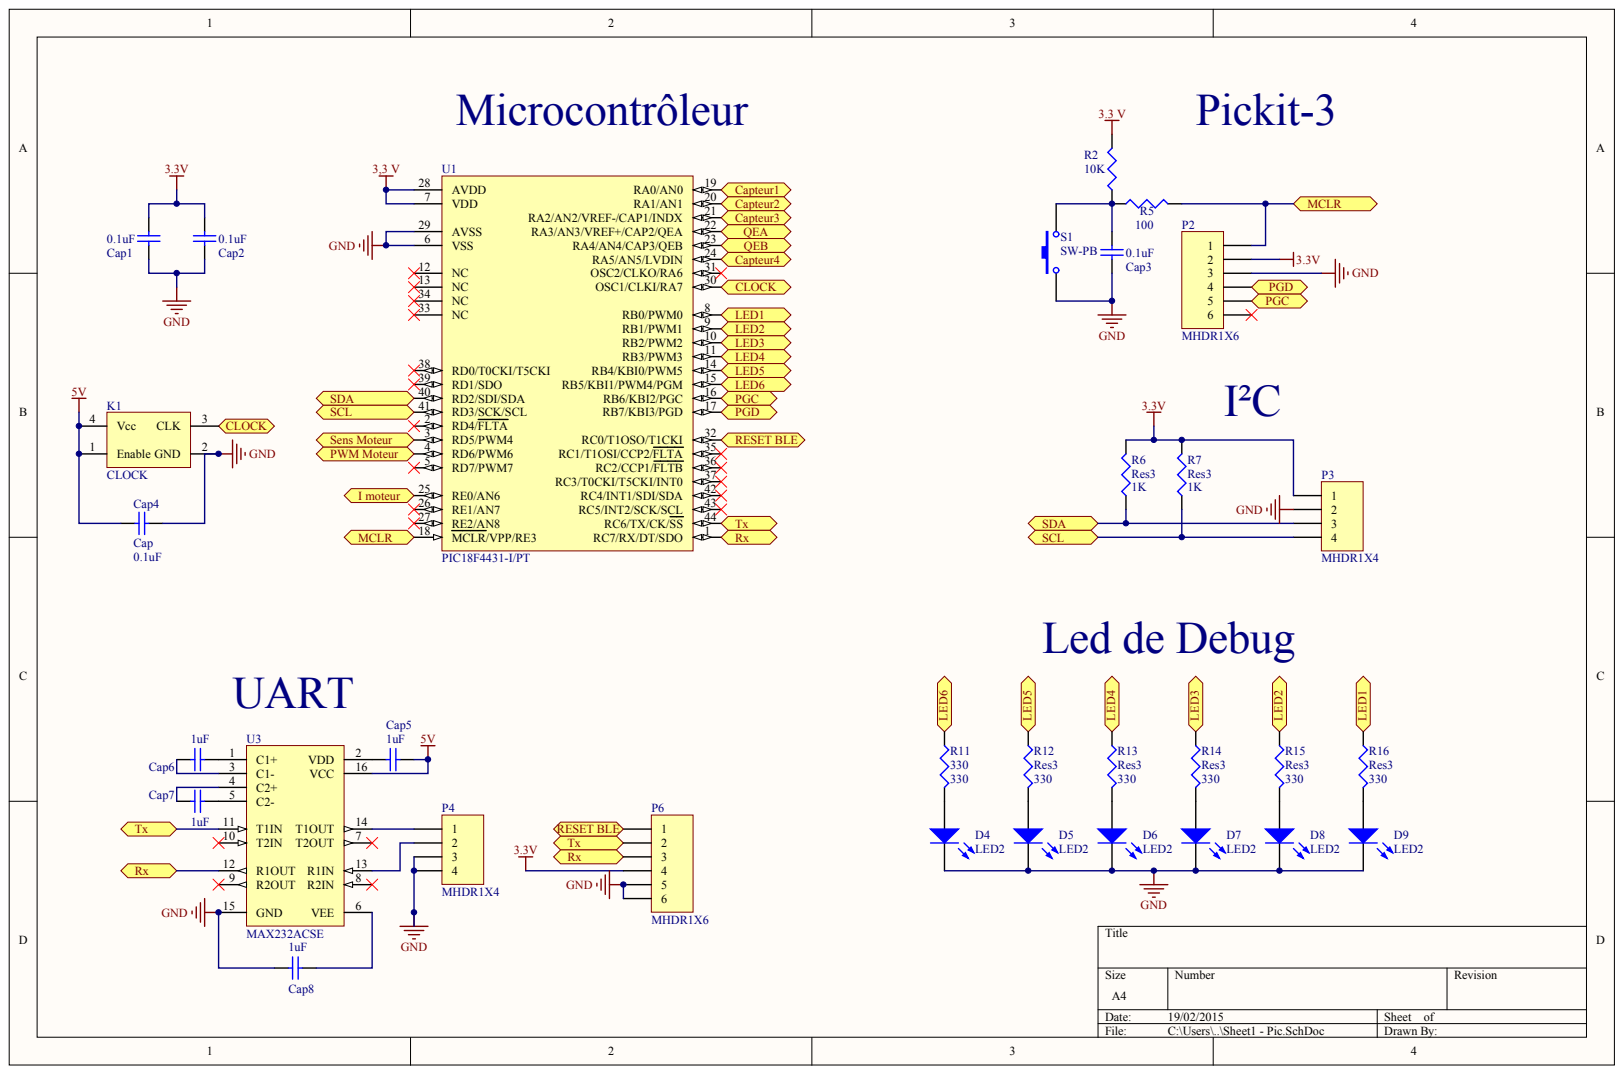
[picture p61: page 2]

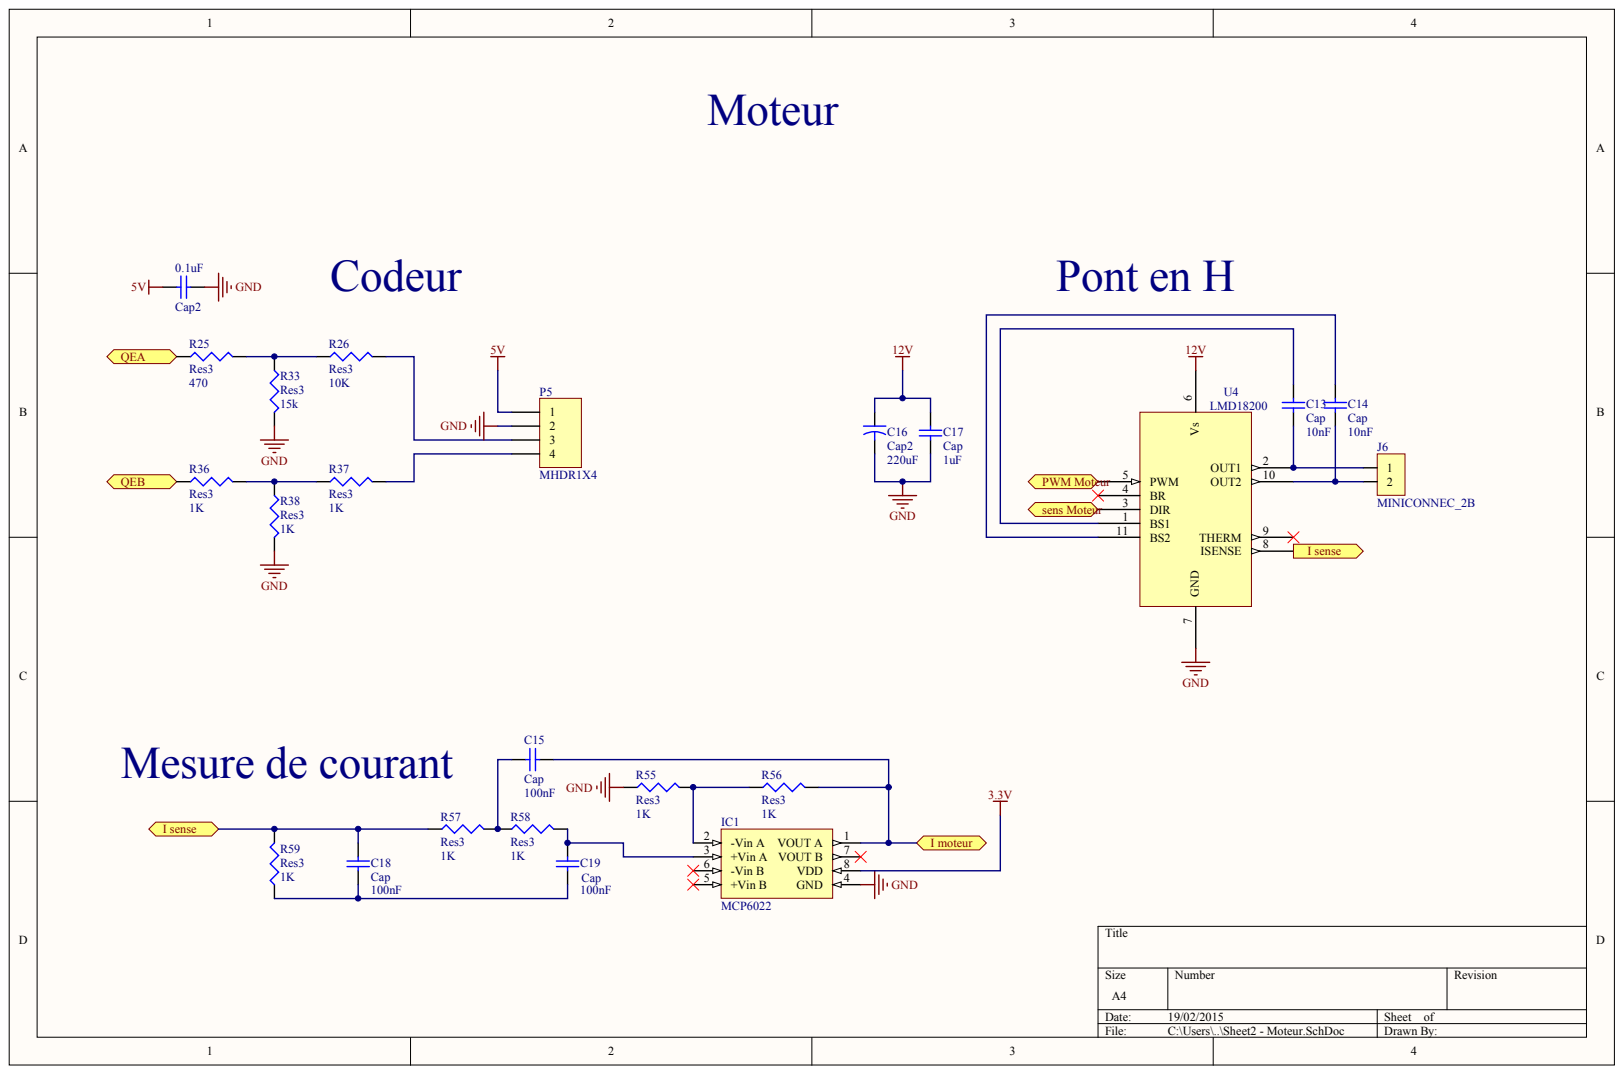
[picture p62: page 3]

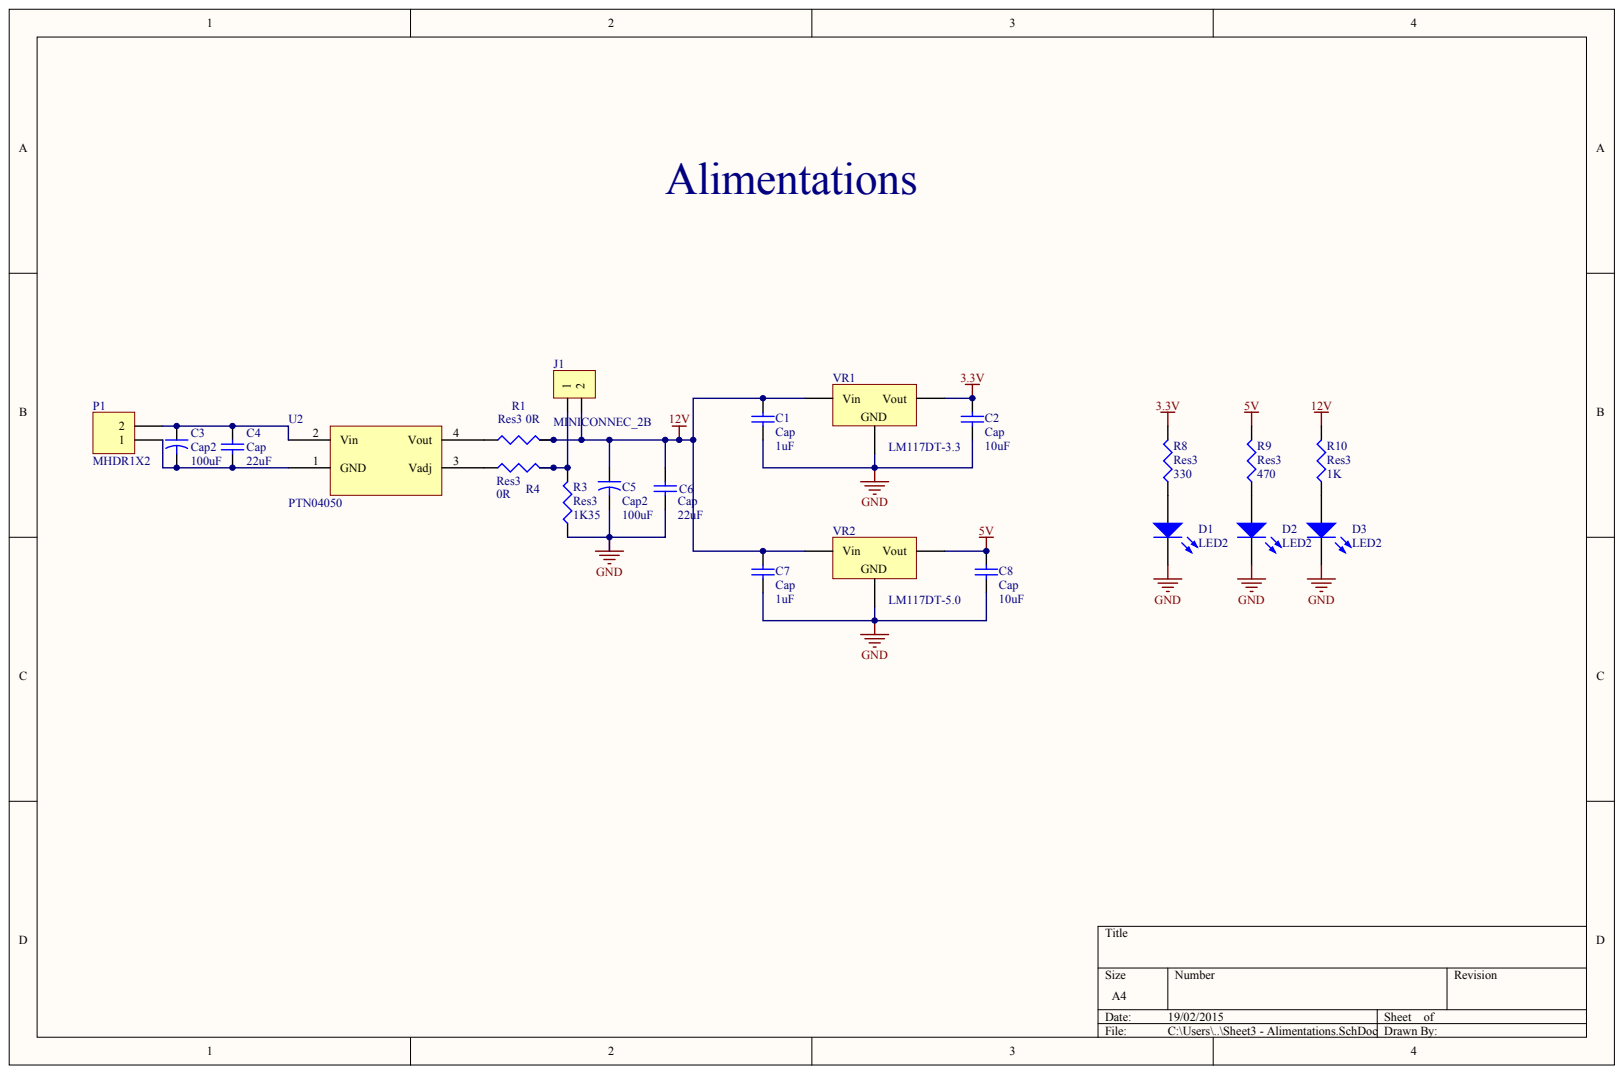
[picture p63: page 4]

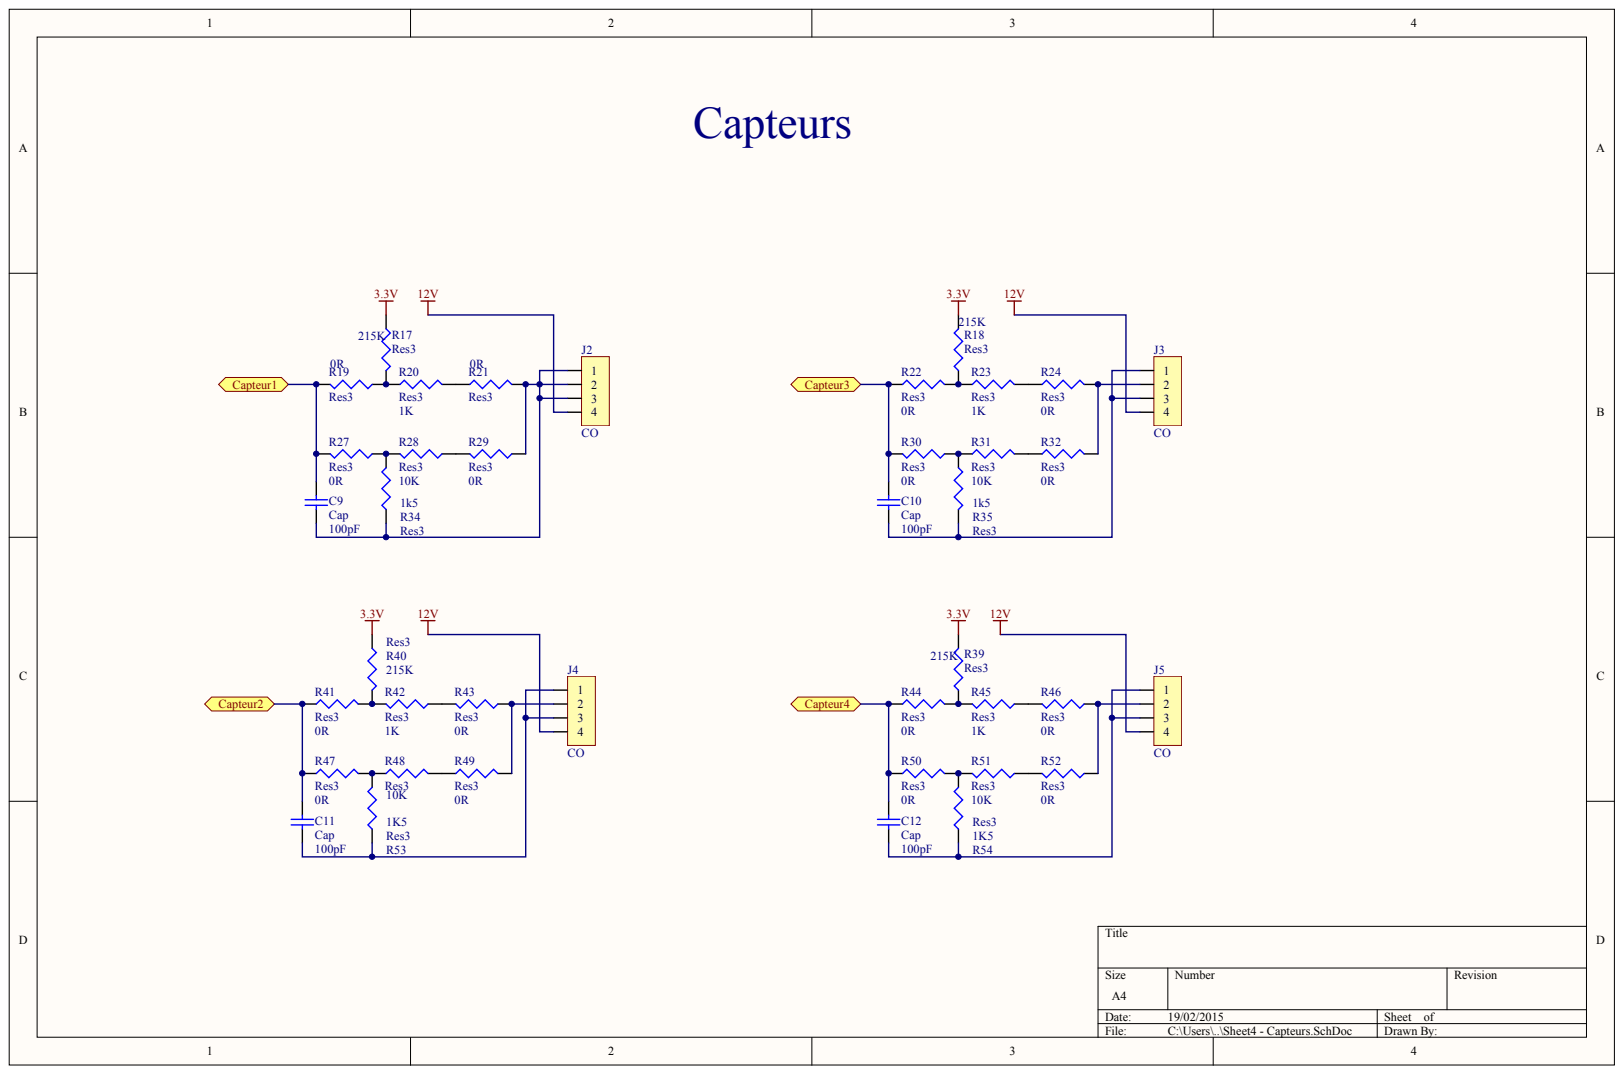
[picture p64: page 5]

0R 10K C9 1k5 | Res3

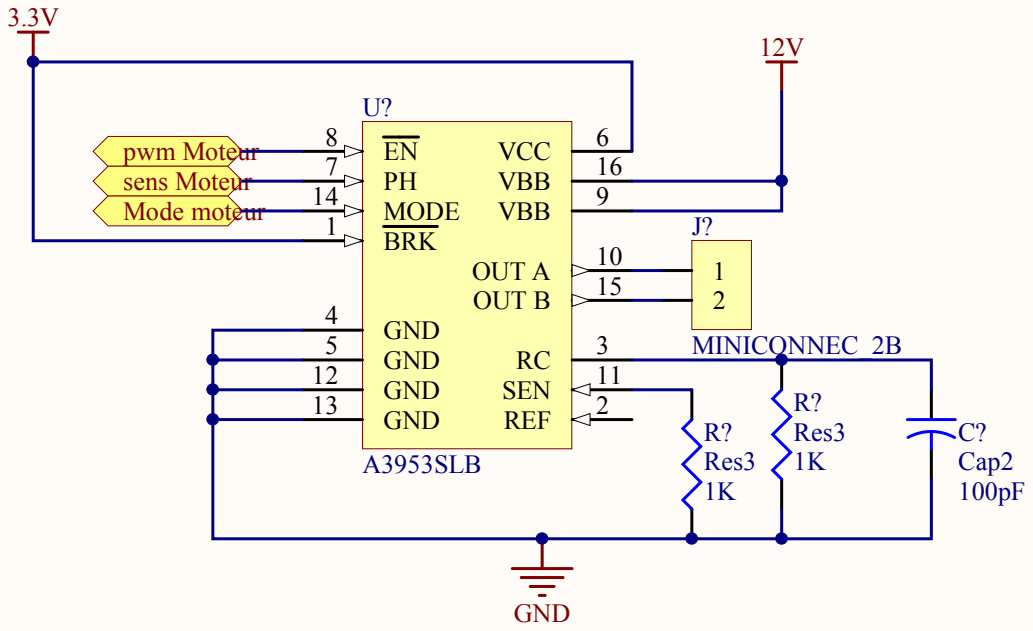
[picture p65: page 6]

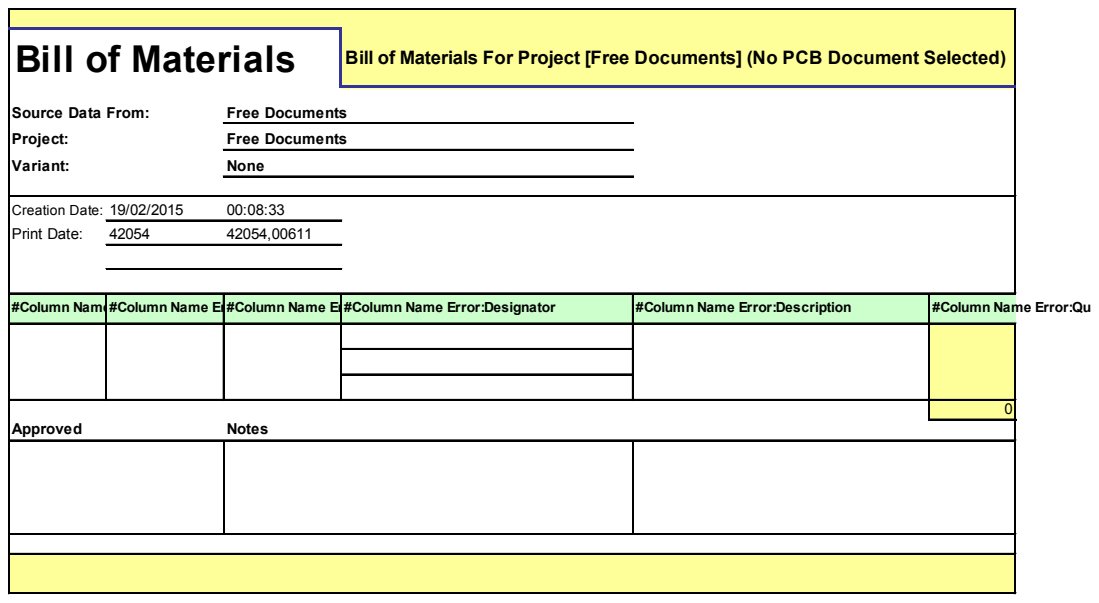
[picture p66: page 7]
