kaostheory78/Projet-Balise/(list of files, drawings)

Other design files:
Schémas Electriques/Altium/usb/651005136421/HDMI_Mini-HDMI.PcbLib
Schémas Electriques/Altium/usb/651005136421/HDMI_Mini-HDMI.SchLib
Schémas Electriques/Altium/usb/651005136421/IEEE1394_Fire Wire.PcbLib
Schémas Electriques/Altium/usb/651005136421/IEEE1394_Fire Wire.SchLib
Schémas Electriques/Altium/usb/651005136421/USB-Mini_USB-Micro_USB.SchLib
Schémas Electriques/Schémas V1/Allegro.SchDoc
Schémas Electriques/Schémas V1/Schémas V1.SchDoc
Schémas Electriques/Schémas V1/Sheet1 - Pic.SchDoc
Schémas Electriques/Schémas V1/Sheet2 - Moteur.SchDoc
Schémas Electriques/Schémas V1/Sheet3 - Alimentations.SchDoc
Schémas Electriques/Schémas V1/Sheet4 - Capteurs.SchDoc
Schémas Electriques/Schémas V2 - bis/PCB1.PcbDoc
Schémas Electriques/Schémas V2 - bis/PCB_Project1.PrjPCB
Schémas Electriques/Schémas V2 - bis/Sheet1.SchDoc
Schémas Electriques/Schémas V2 - wrapping/Allegro.SchDoc
Schémas Electriques/Schémas V2 - wrapping/Schémas V2.PrjPcb
Schémas Electriques/Schémas V2 - wrapping/Schémas V2.SchDoc
Schémas Electriques/Schémas V2 - wrapping/Sheet1 - Pic.SchDoc
Schémas Electriques/Schémas V2 - wrapping/Sheet2 - Moteur.SchDoc
Schémas Electriques/Schémas V2 - wrapping/Sheet3 - Alimentations.SchDoc
Schémas Electriques/Schémas V2 - wrapping/Sheet4 - Capteurs.SchDoc
Schémas Electriques/Schémas V2 - wrapping/Sheet5 - Allegro.SchDoc
Schémas Electriques/Schémas V3 - Routage/connecteur 4/6902 0710 xx 72.PcbLib
Schémas Electriques/Schémas V3 - Routage/connecteur 4/6902 0710 xx 72.SchLib
Schémas Electriques/Schémas V3 - Routage/connecteur 4/6903 5710 xx 72.PcbLib
Schémas Electriques/Schémas V3 - Routage/connecteur 4/6903 5710 xx 72.SchLib
Schémas Electriques/Schémas V3 - Routage/connecteur 4/6903 5728 xx 76.PcbLib
Schémas Electriques/Schémas V3 - Routage/connecteur 4/6903 5728 xx 76.SchLib
Schémas Electriques/Schémas V3 - Routage/connecteur 4/6903 6718 xx 72.PcbLib
Schémas Electriques/Schémas V3 - Routage/connecteur 4/6903 6718 xx 72.SchLib
Schémas Electriques/Schémas V3 - Routage/connecteur 4/6903 6719 xx 72.PcbLib
Schémas Electriques/Schémas V3 - Routage/connecteur 4/6903 6719 xx 72.SchLib
Schémas Electriques/Schémas V3 - Routage/connecteur 4/6903 6728 xx 76.PcbLib
Schémas Electriques/Schémas V3 - Routage/connecteur 4/6903 6728 xx 76.SchLib
Schémas Electriques/Schémas V3 - Routage/connecteur 4/6903 6729 xx 76.PcbLib
Schémas Electriques/Schémas V3 - Routage/connecteur 4/6903 6729 xx 76.SchLib
Schémas Electriques/Schémas V3 - Routage/connecteur 4/6903 6817 xx 72.PcbLib
Schémas Electriques/Schémas V3 - Routage/connecteur 4/6903 6817 xx 72.SchLib
Schémas Electriques/Schémas V3 - Routage/connecteur 4/6903 6818 xx 72.PcbLib
Schémas Electriques/Schémas V3 - Routage/connecteur 4/6903 6818 xx 72.SchLib
Schémas Electriques/Schémas V3 - Routage/connecteur 4/6903 6819 xx 72.PcbLib
Schémas Electriques/Schémas V3 - Routage/connecteur 4/6903 6819 xx 72.SchLib
Schémas Electriques/Schémas V3 - Routage/PCB3 - 5x5 - placement V2.PcbDoc
Schémas Electriques/Schémas V3 - Routage/PCB3 - 5x5 - placement V22.PcbLib
Schémas Electriques/Schémas V3 - Routage/Sheet 1 - Micro.SchDoc
Schémas Electriques/Schémas V3 - Routage/Sheet 2 - Moteurs.SchDoc
Schémas Electriques/Schémas V3 - Routage/Sheet 3 - Alims.SchDoc
Schémas Electriques/Schémas V3 - Routage/Sheet 4 - Capteurs.SchDoc
