kaostheory78/Projet-Balise/Carte Balise.X/Uart.h

 /* 
 * File:   Uart.h
 * Author: Quentin
 *
 * Created on 8 novembre 2015, 14:50
 */

#ifndef UART_H
#define	UART_H


/** D E F I N E S ****************************************/



//Type UART
#define UART_USB                        1   // UART1
#define UART_BLUETOOTH                  1 //2   // UART2


/** P R O T O T Y P E S **********************************/

/**
 * @brief	: Fonction permettant d'initialiser les UART
 * @param	: channel	: channel a initialiser (UART_USB | UART_BLUETOOTH)
 * @param	: baud		: vitesse de communication
 */
void InitUART (uint8_t channel, uint32_t baud);


/**
 * @brief       : Fonction qui permet de modifier la vitesse de communication de l'UART
 * @param       : uart          : Uart dont on veut changer la vitesse (UART_USB | UART_BLUETOOTH)
 * @param       : baud          : Vitesse à atteindre
 */
void modifier_vitesse_com_uart (uint8_t uart, uint32_t baud);

/**
 * @ brief      : Fonction qui permet de calculer la veleur à mettre dans le registre
 *                pour changer le baud rate de l'uart
 *
 * @param       : baud          : valeur souhaitée
 * @return      : valeur à mettre dans le registre
 */
uint16_t calcul_baud (uint32_t baud);

/**
 * @brief       : Vide le buffer de reception de l'uart pour supprimer les données reçues non récupérés
 * @param       : uart          : Uart dont on veut vider le buffer !
 */
void vider_buffer_reception_uart (uint8_t uart);

/**
 * @brief	: Fonction permettant d'envoyer un caractere sur la liaison serie
 * @param	: channel	: channel a initialiser (UART_USB | UART_BLUETOOTH)
 * @param	: octet		: octet a envoyer
 */
void PutcUART (uint8_t channel, uint8_t octet);


/**
 * @brief	: Fonction permettant d'envoyer une chaine de caractere sur la liaison serie
 * @param	: channel	: channel a initialiser (UART_USB | UART_BLUETOOTH)
 * @param	: chaine	: chaine a envoyer
 */
void PutsUART (uint8_t channel, const char *chaine);


/**
 * @brief	: Fonction permettant d'envoyer une chaine de caractere ou une partie sur la liaison serie (utile pour les AX12 par exemple)
 * @param	: channel		: channel a initialiser (UART_USB | UART_BLUETOOTH)
 * @param	: chaine		: chaine a envoyer
 * @param	: taille_chaine	: taille de la chaine ou nombre d'octet a envoyer
 */
void Puts2UART (uint8_t channel, uint8_t *chaine, uint16_t taille_chaine);


/**
 * @brief	: Fonction permettant de convertir un int en chaine de caractere
 * @param	: nb	: nombre a convertir
 * @return	: une chaine contenant le nombre
 */
char *IntToC (int16_t nb);


/**
 * @brief	: Fonction permettant de convertir un long en chaine de caractere
 * @param	: nb	: nombre a convertir
 * @return	: une chaine contenant le nombre
 */
char *LongToC (int32_t nb);


/**
 * @brief	: Fonction permettant d'afficher un int sur la console
 * @param   : uart  : uart utilisée (UART_USB | UART_BLUETOOTH)
 * @param	: nb	: nombre a afficher
 */
void PutIntUART (uint8_t uart, int16_t nb);


/**
 * @brief	: Fonction permettant d'afficher un long sur la console
 * @param   : uart  : uart utilisée (UART_USB | UART_BLUETOOTH)
 * @param	: nb	: nombre a afficher
 */
void PutLongUART (uint8_t uart, int32_t nb);



#endif	/* UART_H */
