kaostheory78/Projet-Balise/(commit log)

2015-01-23 ajout des dossiers
    [Gantt projet.xlsx]
2015-02-04 ajout de doc, et modif CDC et du gantt v2
2015-02-04 ajout du comparatif des technos
2015-02-10 Ajout du comparatif des technos sous excel
    [Comparatif méthodes.xlsx]
2015-02-10 Rajout debut word benchmark techno + méthode
    [Comparatif méthodes.xlsx]
2015-02-11 Ajout de datasheets
    [Comparatif méthodes.xlsx]
2015-02-18 Ajout des schémas elec V1 et des datasheets correspondantes
    [Allegro.SchDoc, Mapping Pic.xlsx, Schémas V1.SchDoc, Sheet1 - Pic.SchDoc, Sheet2 - Moteur.SchDoc, Sheet3 - Alimentations.SchDoc, Sheet4 - Capteurs.SchDoc, Sheet5 - Allegro.SchDoc]
2015-02-28 Ajout des schémas elec de wrapping V2 ainsi que d'une BOM
    [Allegro.SchDoc, Mapping Pic.xlsx, Schémas V1.SchDoc, Schémas V2 - BOM.xlsx, Schémas V2.SchDoc, Sheet1 - Pic.SchDoc, Sheet2 - Moteur.SchDoc, Sheet3 - Alimentations.SchDoc]
2015-03-04 commit des fichiers de routages v3
    [Carte Balise.PrjPCB, PCB1.PcbDoc, PCB_Project1.PrjPCB, Sheet 1 - Micro.SchDoc, Sheet 2 - Moteurs.SchDoc, Sheet 3 - Alims.SchDoc, Sheet 4 - Capteurs.SchDoc, Sheet1.SchDoc]
2015-03-09 Ajout des erratas datasheets pic
    [Carte Balise.PrjPCB, Schémas V2 - BOM.xlsx, Sheet 1 - Micro.SchDoc, Sheet 2 - Moteurs.SchDoc, Sheet 3 - Alims.SchDoc, Sheet 4 - Capteurs.SchDoc]
2015-03-09 Début du code Balise : Ajout des configs système et uart
2015-03-21 maj ..
    [Sheet 1 - Micro.SchDoc, Sheet 2 - Moteurs.SchDoc, Sheet 3 - Alims.SchDoc, Sheet 4 - Capteurs.SchDoc]
2015-03-21 maj avec ajout des fichiers
    [6902 0710 xx 72.PcbLib, 6902 0710 xx 72.SchLib, 6903 5710 xx 72.PcbLib, 6903 5710 xx 72.SchLib, 6903 5728 xx 76.PcbLib, 6903 5728 xx 76.SchLib, 6903 6718 xx 72.PcbLib, 6903 6718 xx 72.SchLib]
2015-03-28 Commit ...
    [Carte Balise.PrjPCB, Code.production.obj, PCB1.PcbDoc, l.obj]
2015-04-03 Nouveau commit
    [Code.production.obj, l.obj]
2015-04-12 Ajout de QEI, et l'obtention de l'angle
    [Code.production.obj, l.obj]
2015-04-17 commit pour Julie
    [Code.production.obj, l.obj]
2015-04-28 commit mix version pour backup....
    [Carte Balise.PrjPCB, Code.production.obj, PCB1.PcbDoc, Sheet 1 - Micro.SchDoc, Sheet 2 - Moteurs.SchDoc, Sheet 3 - Alims.SchDoc, Sheet 4 - Capteurs.SchDoc]
2015-05-03 Comparaison angle plus recherche balise mère par comparaison de position précédente
    [Code.production.obj]
2015-05-03 Modif de l'algo de détection de changement de balise. On ne s'occupe plus d'essayer de retrouver la balise mère. Par contre à chaque tour on fait les calculs de triangulations pour les 3 angles. On c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
    [Code.production.obj]
2015-05-09 Commit pour Amina
    [Code.production.obj]
2015-07-11 nouveau altium
    [Carte Balise.PrjPCB, Code.production.obj, PCB1.PcbDoc, PCB2.PcbDoc, Sheet 1 - Micro.SchDoc, Sheet 2 - Moteurs.SchDoc, Sheet 3 - Alims.SchDoc, Sheet 4 - Capteurs.SchDoc]
2015-07-19 ajout de toutes les footprints
    [Carte Balise.xls, PCB2.PcbDoc, Sheet 1 - Micro.CSV, Sheet 1 - Micro.SchDoc, Sheet 2 - Moteurs.SchDoc, Sheet 3 - Alims.SchDoc, Sheet 4 - Capteurs.SchDoc]
2015-08-02 commit pour changement d'ordi, v1 pcb
    [Carte Balise.PrjPCB, PCB2 - Copie.PcbDoc, PCB2.PcbDoc, PCB3 - 5x5 - placement V1.PcbDoc, PCB3 - 5x5 - placement V2.PcbDoc, PCB3 - 5x5.PcbDoc, PCB3.PcbDoc, Sheet 1 - Micro.SchDoc]
2015-08-14 changement de pc
    [Carte Balise.PrjPCB, PCB3 - 5x5 - placement V2.PcbDoc, Sheet 1 - Micro.SchDoc, Sheet 2 - Moteurs.SchDoc, Sheet 3 - Alims.SchDoc, Sheet 4 - Capteurs.SchDoc]
2015-10-11 Routege termine, commit pour sauvegarde
    [Bill of Materials-Carte Balise.xls, Carte Balise.PrjPCB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]
2015-11-04 Mise à jour de la BOM et du altium
    [Bill of Materials-Carte Balise.xls, Carte Balise.PrjPCB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]
2015-11-05 Modification des footprints, avec ajouts des assembly drawings Révision du 05/11/2015 Carte prête pour soudage
    [6903 6728 xx 76.PcbLib, Carte Balise.PrjPCB, Carte Balise.xls, HDMI_Mini-HDMI.PcbLib, HDMI_Mini-HDMI.SchLib, IEEE1394_Fire Wire.PcbLib, IEEE1394_Fire Wire.SchLib, PCB1.PcbDoc]
2016-01-16 ajout du dsoic
    [Calcul Baud_rate.xlsx, Carte Balise.PrjPCB, Mapping carte stratV1.xlsx, Réglage Fréquence et Timer.xlsx]
2016-01-17 Carte testée Test du QEI Test du capteur Test PWM Test CLock (fail donc clock interne) Mise en place + Test asserv bidon Remise en place de la triangulation Test Uart USB
    [Config_robots.h, Uart.h, asserv.c, asserv.h, codeurs.h, interruptions.c, interruptions.h, main.c]
2016-04-10 tentative boussole
    [Réglage Fréquence et Timer.xlsx]
2016-05-28 Test bitfield carte strategie
    Utilisation de la carte pour tester la mise en place de bit field dans
    le code de la carte stratégie.
    (Par ce que je n'avais pas de carte sous la main)
2017-03-19 modif i2c non concluantes
2017-03-19 ordi portable
    [690367280476.sldasm, 690367280676.sldasm, 691321100002.sldasm, 6913211000xx_PIN.sldprt, 691325110002.sldprt, 776235712.sldasm, 776235872.sldasm, 776236032.sldasm]
